md80av8r/AudioBox/report.txt

Plotted to '/Users/jeffreykadans/Developer/MicBreakoutBoxrev_C/REV.C.MAIN.BOARD.COMPLETE/md88_breakout_main_revC-F_Cu.gbr'.
Plotted to '/Users/jeffreykadans/Developer/MicBreakoutBoxrev_C/REV.C.MAIN.BOARD.COMPLETE/md88_breakout_main_revC-In1_Cu.gbr'.
Plotted to '/Users/jeffreykadans/Developer/MicBreakoutBoxrev_C/REV.C.MAIN.BOARD.COMPLETE/md88_breakout_main_revC-In2_Cu.gbr'.
Plotted to '/Users/jeffreykadans/Developer/MicBreakoutBoxrev_C/REV.C.MAIN.BOARD.COMPLETE/md88_breakout_main_revC-B_Cu.gbr'.
Plotted to '/Users/jeffreykadans/Developer/MicBreakoutBoxrev_C/REV.C.MAIN.BOARD.COMPLETE/md88_breakout_main_revC-F_Adhesive.gbr'.
Plotted to '/Users/jeffreykadans/Developer/MicBreakoutBoxrev_C/REV.C.MAIN.BOARD.COMPLETE/md88_breakout_main_revC-B_Adhesive.gbr'.
Plotted to '/Users/jeffreykadans/Developer/MicBreakoutBoxrev_C/REV.C.MAIN.BOARD.COMPLETE/md88_breakout_main_revC-F_Paste.gbr'.
Plotted to '/Users/jeffreykadans/Developer/MicBreakoutBoxrev_C/REV.C.MAIN.BOARD.COMPLETE/md88_breakout_main_revC-B_Paste.gbr'.
Plotted to '/Users/jeffreykadans/Developer/MicBreakoutBoxrev_C/REV.C.MAIN.BOARD.COMPLETE/md88_breakout_main_revC-F_Silkscreen.gbr'.
Plotted to '/Users/jeffreykadans/Developer/MicBreakoutBoxrev_C/REV.C.MAIN.BOARD.COMPLETE/md88_breakout_main_revC-B_Silkscreen.gbr'.
Plotted to '/Users/jeffreykadans/Developer/MicBreakoutBoxrev_C/REV.C.MAIN.BOARD.COMPLETE/md88_breakout_main_revC-F_Mask.gbr'.
Plotted to '/Users/jeffreykadans/Developer/MicBreakoutBoxrev_C/REV.C.MAIN.BOARD.COMPLETE/md88_breakout_main_revC-B_Mask.gbr'.
Plotted to '/Users/jeffreykadans/Developer/MicBreakoutBoxrev_C/REV.C.MAIN.BOARD.COMPLETE/md88_breakout_main_revC-Edge_Cuts.gbr'.
Created Gerber job file '/Users/jeffreykadans/Developer/MicBreakoutBoxrev_C/REV.C.MAIN.BOARD.COMPLETE/md88_breakout_main_revC-job.gbrjob'.
Info: Done.
