md80av8r/AudioBox/audio_companion/fab_v7/board_bottom.png

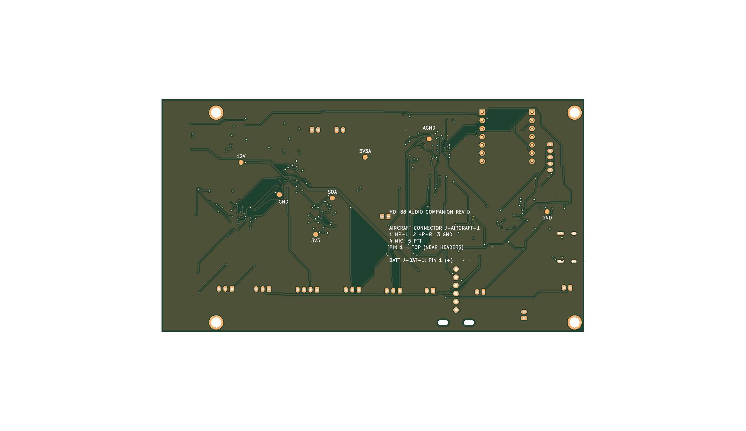
audio_companion/fab_v7/board_bottom.png
