md80av8r/AudioBox/audio_companion/fab_v7/board_top.png

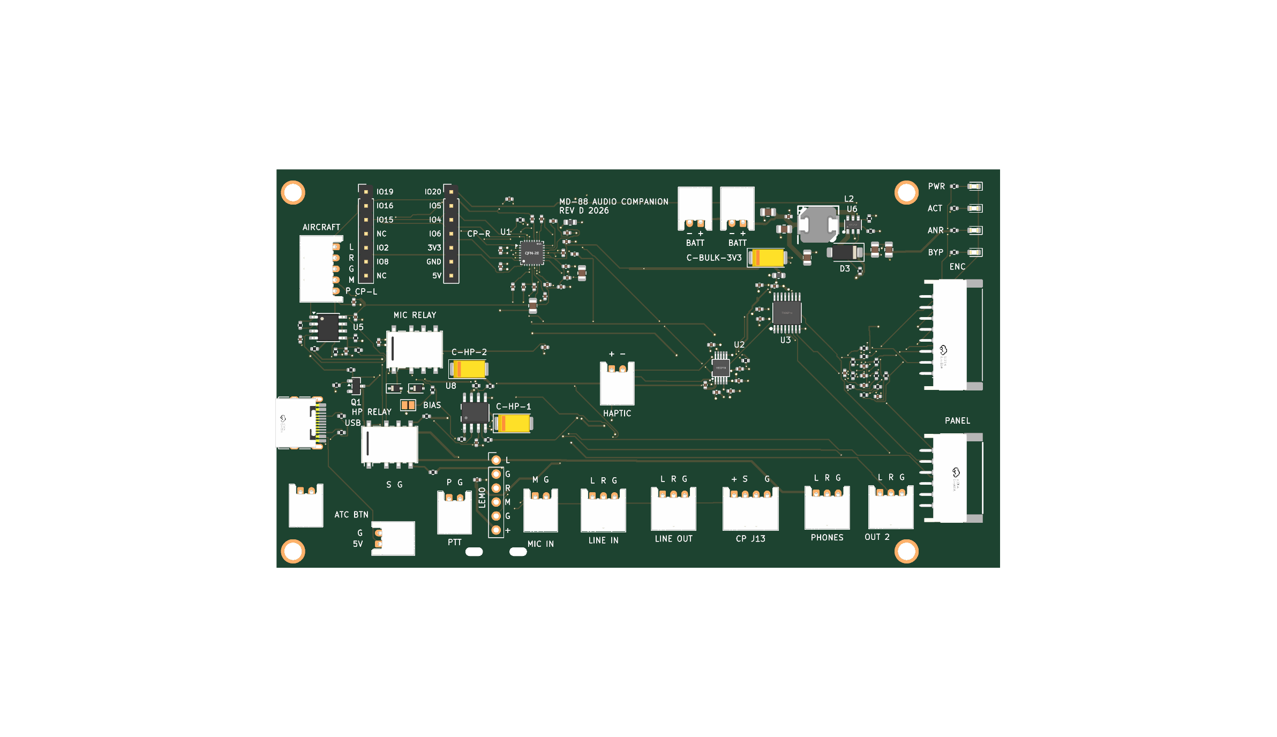
audio_companion/fab_v7/board_top.png
