md80av8r/AudioBox/REV.C.MAIN.BOARD.COMPLETE/BOM_JLCPCB.csv

Comment | Designator | Footprint | LCSC Part #
18650_CELL | BT1 | CONN-SMD_B2B-PH-SM4-TB-LF-SN | C160352
100nF | C1,C2,C3,C14,C16,C20,C21,C23,C25,C26,C29,C_HP_VCC_DECAP1 | C_0805_2012Metric | C49678
10uF | C6,C9,C12,C13,C18,C_HP_VCC_BULK1 | C_0805_2012Metric | C15850
1uF | C8,C17,C_BYPASS1 | C_0805_2012Metric | C28323
22uF | C10,C11,C15,C19,C24 | C_0805_2012Metric | C45783
10uF | C22,C_AC_COUPLE1,C_AF1 | C_1210_3225Metric
MIC_PIGTAIL_0206 | CABLE1 | CONN-SMD_B2B-PH-SM4-TB-LF-SN | C160352
AUDIO_PIGTAIL_QUARTER_INCH | CABLE2 | CONN-SMD_B3B-PH-SM4-TB-LF-SN | C160353
B2B-PH-SM4-TB | CN2,CN3 | CONN-SMD_B2B-PH-SM4-TB-LF-SN | C160352
100nF | C_AF_BIAS1 | C_1210_3225Metric
1nF | C_HP_FILTER1 | C_0805_2012Metric | C46653
PM101M025E077PTR | C_OUT_L1,C_OUT_R1 | CAP-SMD_BD6.3-L6.6-W6.6-LS7.2-FD | C2858382
SS24 | D1,D3 | SMA_L4.3-W2.6-LS5.2-RD | C50645
LED_CHRG_RED | D4 | LED_0805_2012Metric
LED_CHRG_GREEN | D5 | LED_0805_2012Metric
FH28K-20S-0.5SH | FPC1 | CONN-SMD_FH28K-20S-0.5SH | C3168665
USB_C_POWER | J1 | USB_C_Receptacle_HRO_TYPE-C-31-M-12 | C165948
AUDIO_OUT_QUARTER_INCH | J2 | CONN-SMD_B3B-PH-SM4-TB-LF-SN | C160353
MIC_OUT_0206 | J3 | CONN-SMD_B3B-PH-SM4-TB-LF-SN | C160353
LEMO_6PIN_PROFLIGHT | J4 | CONN-SMD_6P-P2.00_B6B-PH-SM4-TB-LF-SN | C471518
AUX_IN_3.5MM | J5 | CONN-SMD_B3B-PH-SM4-TB-LF-SN | C160353
4.7uH | L1,L2 | IND-SMD_L4.0-W4.0_LQH44PN2R2MP0L | C135263
SMNR4020-10UH | L3 | IND-SMD_L4.0-W4.0_LQH44PN2R2MP0L | C135263
FS8205A_C2830320 | Q1 | SOT-23-6_L2.9-W1.6-P0.95-LS2.8-BR | C2830320
MMBT3904-C20526 | Q2,Q3,Q5 | SOT-23-3_L2.9-W1.3-P1.90-LS2.4-BR | C20526
AO3401A | Q4 | SOT-23_L2.9-W1.3-P1.90-LS2.4-BR | C15127
4.7k | R1,R29 | R_0805_2012Metric | C17673
10k | R2,R15,R21,R27,R28,R30,R31,R32,R33,R40,R41,R_AF1,R_AF2,R_BASE_PD1,R_BTN_BASE1,R_BTN_BASE2,R_BTN_BASE3,R_HOLD_BASE1,R_PWR_PU1 | R_0805_2012Metric | C17414
470 | R6 | R_0805_2012Metric | C17710
100k | R8,R9,R18,R19,R34,R35,R36,R_AF_BIAS1,R_AF_BIAS2,R_SHUTDOWN1 | R_0805_2012Metric | C17407
180k | R14 | R_0805_2012Metric | C22827
200k | R16 | R_0805_2012Metric | C17539
27k | R17 | R_0805_2012Metric | C17593
1k | R22,R23 | R_0805_2012Metric | C17513
100 | R24 | R_0805_2012Metric | C17408
5.1k | R25,R26 | R_0805_2012Metric | C27834
ESP32-WROVER-E-N8R8 | U1 | WIFI-SMD_ESP32-WROVER-IE8MB | C2973667
DS3231SN#_C722469 | U2 | SOIC-16_L10.3-W7.5-P1.27-LS10.3-BL | C722469
BME280 | U3 | LGA-8_BME280_BL | C92489
MT3608 | U9,U10 | SOT-23-6
TP4056 | U11 | ESOP-8_L4.9-W3.9-P1.27-LS6.0-BL-EP | C16581
DW01A_C351410 | U12 | SOT-23-6_L2.9-W1.6-P0.95-LS2.8-BL | C351410
AMS1117-3.3 | U13 | SOT-223-3_L6.5-W3.4-P2.30-LS7.0-BR | C6186
CH340C_C7464026 | U14 | SOP-16_L10.0-W3.9-P1.27-LS6.0-BL | C7464026
MAX98357AETE+T | U15 | TQFN-16_L3.0-W3.0-P0.50-BL-EP1.5 | C910544
TPA6111A2DR | U16 | SOIC-8_L5.0-W4.0-P1.27-LS6.0-BL | C497472
