md80av8r/AudioBox/audio_companion/fab_v7/BOM_full.csv

Value | Designators | Qty | Package | Manufacturer part | LCSC # | Assembly | Notes
S5B-PH-K-S | J-AIRCRAFT-1 | 1 | THT | S5B-PH-K-S(LF)(SN) | C157923 | hand solder | JST PH 5-pin side entry
S4B-PH-K-S | J-BTN-IN-1 | 1 | THT | S4B-PH-K-S(LF)(SN) | C157926 | hand solder | JST PH 4-pin side entry
S3B-PH-K-S | J-35-1,J-35-2,J-35-3,J-635-IN-1 | 4 | THT | S3B-PH-K-S(LF)(SN) | C157929 | hand solder | JST PH 3-pin side entry
S2B-PH-K-S | J-BAT-1,J-BAT-2,J-BTN-1,J-HAPTIC-1,J-MIC-IN-1,J-USB5V-1,PTT_PASS/GND-1 | 7 | THT | S2B-PH-K-S(LF)(SN) | C173752 | hand solder | JST PH 2-pin side entry
Conn_01x07_Socket | HDR-CP-L-1,HDR-CP-R-1 | 2 | THT | 1x7 male header, 19mm LONG pins | NOT_ON_LCSC | hand solder | stack-on to CrowPanel - source separately, pin length must bridge the 10mm gap
LEMO-6P | J-LEMO-1 | 1 | holes | (6 plated holes) | - | no part | LEMO pigtail wires soldered direct + zip-tie slots
SolderJumper | JP-MIC-BIAS-1 | 1 | pads | (PCB pads only) | - | no part | MIC BIAS jumper - bridge with solder to enable electret bias
TP | TP1,TP2,TP3,TP4,TP5,TP6,TP7 | 7 | pads | (PCB pads only) | - | no part | bottom test pads
1k | R9,R-GATE-1 | 2 | 0402 | 0402WGF1001TCE | C11702 | JLCPCB assembles | 1k
LED Green | D4 | 1 | 0603 | KT-0603G | C12624 | JLCPCB assembles | PWR - emerald green
10nF | C-ENC-IA,C-ENC-IB,C-ENC-OA,C-ENC-OB,C-ENC-PUSH | 5 | 0402 | CL05B103KB5NNNC | C15195 | JLCPCB assembles | 10nF 50V X7R - encoder debounce
100nF | C3,C6,C19,C22,C28,C30,C35,C37,C44,C47,C-DRV-VDD-1 | 11 | 0402 | CL05B104KO5NNNC | C1525 | JLCPCB assembles | 100nF 16V X7R
10uF | C7,C8,C20,C21,C25,C27,C33,C34,C36,C38,C41,C42,C43,C45,C48,C49,C50,C-DRV-VDD-2 | 18 | 0402 | CL05A106MQ5NUNC | C15525 | JLCPCB assembles | 10uF 6.3V X5R (3V3 rails only)
10uF | C1,C2 | 2 | 0805 | CL21A106KAYNNNE | C15850 | JLCPCB assembles | 10uF 25V X5R
TYPE-C-31-M-12 | J-USB-1 | 1 | USB-C 16P SMD | TYPE-C-31-M-12 | C165948 | JLCPCB assembles | power-in jack (left edge)
0 | R1 | 1 | 0402 | 0402WGF0000TCE | C17168 | JLCPCB assembles | 0R AGND/GND tie
FerriteBead | FB1,FB3 | 2 | 0603 | BLM18AG601SN1D | C19330 | JLCPCB assembles | 600R@100MHz 500mA
220UF | C-BULK-3V3 | 1 | 6032-28 | T491C227M006AT | C1952817 | JLCPCB assembles | 220uF 6.3V tantalum - + toward pad 1 marking
220uF 6.3V | C-HP-1,C-HP-2 | 2 | 6032-28 | T491C227M006AT | C1952817 | JLCPCB assembles | 220uF 6.3V tantalum - headphone output coupling, + toward TPA
AO3400A | Q1 | 1 | SOT-23 | AO3400A | C20917 | JLCPCB assembles | relay driver, logic-level 30V 5.7A, Basic
1N4148WS | D1,D2 | 2 | SOD-323 | 1N4148WS | C2128 | JLCPCB assembles | relay flyback
G6K-2F-Y DC3 | HEADPHONE_BYPASS-1,MIC_BYPASS-1 | 2 | SMD 10x6.5 | G6K-2F-Y-TR DC3 | C2153097 | JLCPCB assembles | Omron DPDT 3V coil SMT (alt C93168, not recommended for new designs)
LED Red | D7 | 1 | 0603 | KT-0603R | C2286 | JLCPCB assembles | BYPASS - red
LED Yellow | D5 | 1 | 0603 | KT-0603Y | C2287 | JLCPCB assembles | ACTIVE - yellow
LED White | D6 | 1 | 0603 | KT-0603W | C2290 | JLCPCB assembles | ANR 12V - white
SS14 | D3 | 1 | SMA | SS14 | C2480 | JLCPCB assembles | Schottky 40V 1A - boost rectifier
100R | R12 | 1 | 0402 | 0402WGF1000TCE | C25076 | JLCPCB assembles | 100R
10R | R-HP-1,R-HP-2 | 2 | 0402 | 0402WGF100JTCE | C25077 | JLCPCB assembles | 10R
330R | R13,R15 | 2 | 0402 | 0402WGF3300TCE | C25104 | JLCPCB assembles | 330R
100k | R8,R-MICBIAS-1 | 2 | 0402 | 0402WGF1003TCE | C25741 | JLCPCB assembles | 100k
10k | R11,R-BIAS1,R-BIAS2,R-BYP-SENSE-1,R-ENC-PU-IA,R-ENC-PU-IB,R-ENC-PU-OA,R-ENC-PU-OB,R-ENC-PU-PUSH,R-ENC-S-IA,R-ENC-S-IB,R-ENC-S-OA,R-ENC-S-OB,R-ENC-S-PUSH,R-PULL-1,R-TPA-FB-1,R-TPA-FB-2,R-TPA-IN-1,R-TPA-IN-2 | 19 | 0402 | 0402WGF1002TCE | C25744 | JLCPCB assembles | 10k
200k | R-FB-TOP-2 | 1 | 0402 | 0402WGF2003TCE | C25764 | JLCPCB assembles | 200k
22k | R10 | 1 | 0402 | 0402WGF2202TCE | C25768 | JLCPCB assembles | 22k
2.2k | R14,R-ELEC-1 | 2 | 0402 | 0402WGF2201TCE | C25879 | JLCPCB assembles | 2.2k
5.1k | R-CC-1,R-CC-2 | 2 | 0402 | 0402WGF5101TCE | C25905 | JLCPCB assembles | 5.1k CC pull-down for USB-C power-in
S8B-PH-SM4-TB | J-ENC-1 | 1 | JST PH 8P SMD side | S8B-PH-SM4-TB(LF)(SN) | C265121 | JLCPCB assembles | encoder cable connector
S6B-PH-SM4-TB | J-PANEL-1 | 1 | JST PH 6P SMD side | S6B-PH-SM4-TB(LF)(SN) | C265405 | JLCPCB assembles | panel switches cable connector
PCA9534APWR | U3 | 1 | TSSOP-16 | PCA9534APWR | C2871127 | JLCPCB assembles | I2C IO expander
ES8388 | U1 | 1 | QFN-28-EP(4x4) | ES8388 | C365736 | JLCPCB assembles | audio codec
22uF 10V | C29,C31,C32 | 3 | 0805 | CL21A226MAQNNNE | C45783 | JLCPCB assembles | 22uF 25V X5R (covers 10V use)
22uF 25V | C46,C51 | 2 | 0805 | CL21A226MAQNNNE | C45783 | JLCPCB assembles | 22uF 25V X5R - boost output, must be >=25V
TPA6111A2DR | U8 | 1 | SOIC-8 | TPA6111A2DR | C497472 | JLCPCB assembles | headphone amp
DRV2605LDGSR | U2 | 1 | VSSOP-10 | DRV2605LDGSR | C527464 | JLCPCB assembles | haptic driver
1uF | C9,C23,C24,C26,C39,C40,C-DRV-REG-1 | 7 | 0402 | CL05A105KA5NQNC | C52923 | JLCPCB assembles | 1uF 25V X5R
1uF 25V | C-MIC-AIR-1 | 1 | 0402 | CL05A105KA5NQNC | C52923 | JLCPCB assembles | 1uF 25V X5R - mic DC block, keep >=16V
MCP6022 | U5 | 1 | SOIC-8 | MCP6022T-I/SN | C57639 | JLCPCB assembles | dual op amp
SPM6530T-4R7M | L2 | 1 | 7.1x6.5 | SPM6530T-4R7M | C76857 | JLCPCB assembles | TDK 4.7uH 5.6A
MT3608 | U6 | 1 | SOT-23-6 | MT3608 | C84817 | JLCPCB assembles | 12V boost
