md80av8r/AudioBox/md88_breakout/gerbers/md88_breakout_BOM_JLCPCB.csv

Comment | Designator | Footprint | LCSC Part #
100nF | C3 | 0805 | C49678
1uF | C8 | 0805 | C28323
4.7k | R1 | 0805 | C17730
10k | R2,R3,R4,R5,R10,R11 | 0805 | C17414
470 | R6 | 0805 | C17745
100k | R8,R9,R18,R19 | 0805 | C17407
5.1k | R12,R13 | 0805 | C23186
