md80av8r/AudioBox/REV.C.PANEL.BOARD.COMPLETE/BOM_JLCPCB.csv

Comment | Designator | Footprint | LCSC Part #
100nF | C1,C3 | C_0805_2012Metric | C49678
KH-FG0.5-H2.0-14PIN | CN2 | FPC-SMD_KH-FG0.5-H2.0-14PIN | C2797208
FH28K-20S-0.5SH | FPC2 | CONN-SMD_FH28K-20S-0.5SH | C3168665
10k | R2,R4,R5 | R_0805_2012Metric | C17414
4.7k | R6,R7 | R_0805_2012Metric | C17673
EC11E15244G1 | SW1 | SW-TH_EC11E15244G1 | C370970
EVPAA202K | SW3 | KEY-SMD_4P-L3.5-W2.9-P1.48-LS4.3-TL | C79147
