md80av8r/AudioBox/audio_companion/3d/CONN-SMD_PH2.00-WS-6P.step

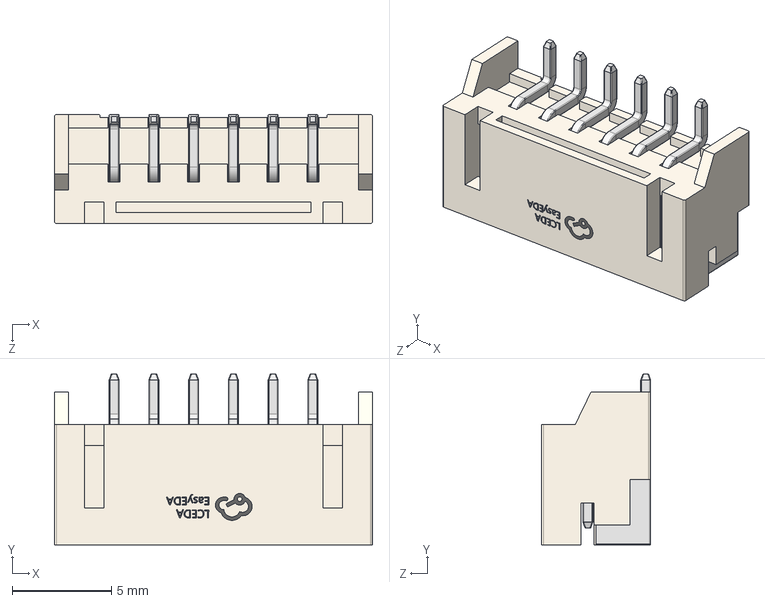
[picture p3: CAD file, 2026-11-12]
audio_companion/3d/CONN-SMD_PH2.00-WS-6P.step
16.0 x 8.60 x 5.50 mm
