md80av8r/AudioBox/audio_companion/3d/CONN-SMD_PH2.00-WS-8P.step

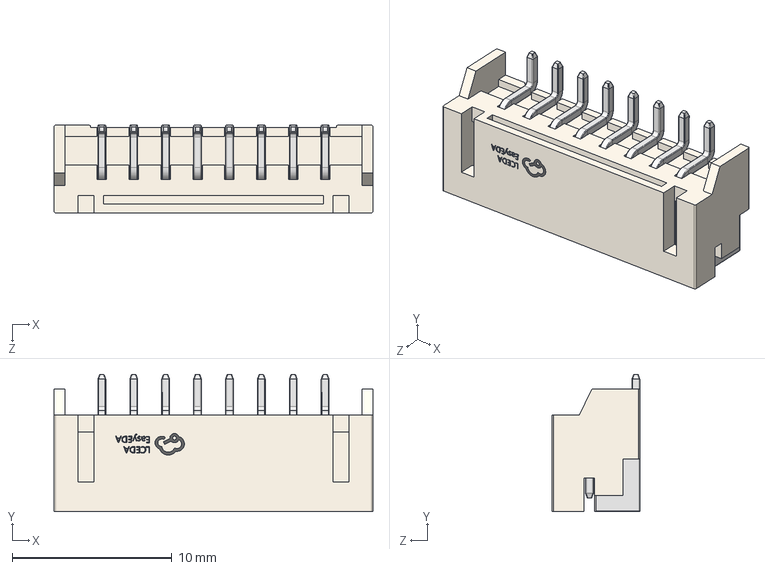
[picture p4: CAD file, 2026-11-12]
audio_companion/3d/CONN-SMD_PH2.00-WS-8P.step
20.0 x 8.60 x 5.50 mm
