md80av8r/AudioBox/md88_breakout/kicad.pdf

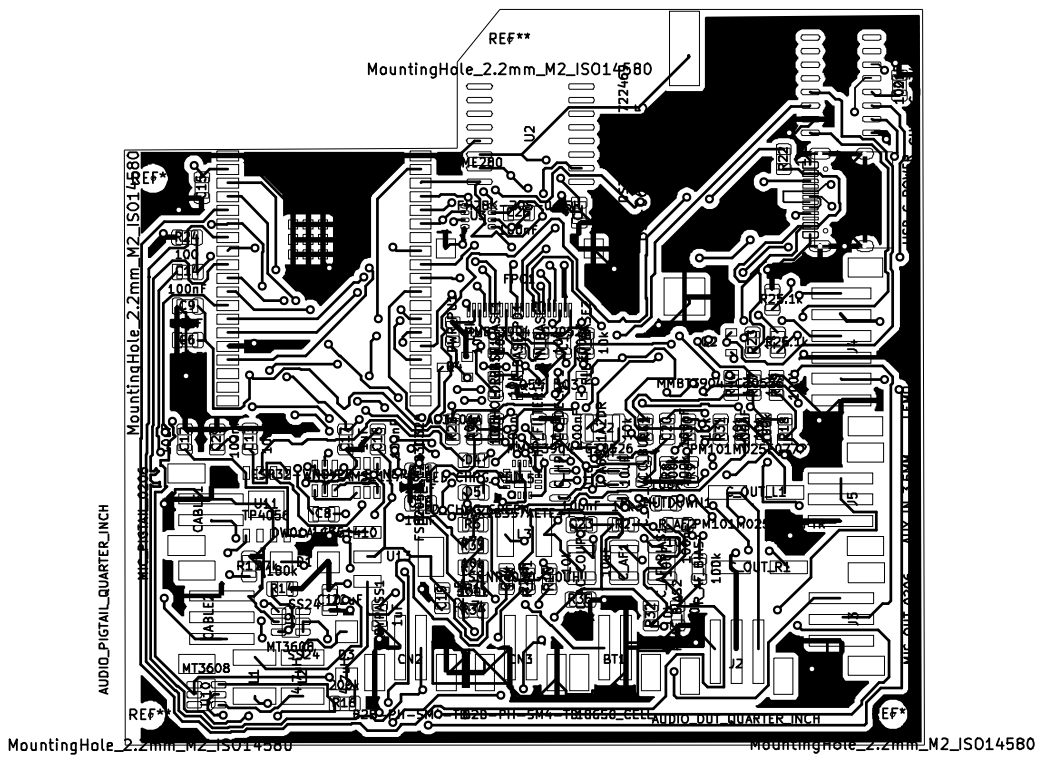
[picture p5: page 1]
