md80av8r/AudioBox/(list of files, drawings)

Other design files:
md88_breakout/_archive_revB/md88_breakout.dsn
