md80av8r/AudioBox/audio_companion/audio_companion.kicad_pcb

## KiCad design audio_companion/audio_companion.kicad_pcb (2026-11-12)

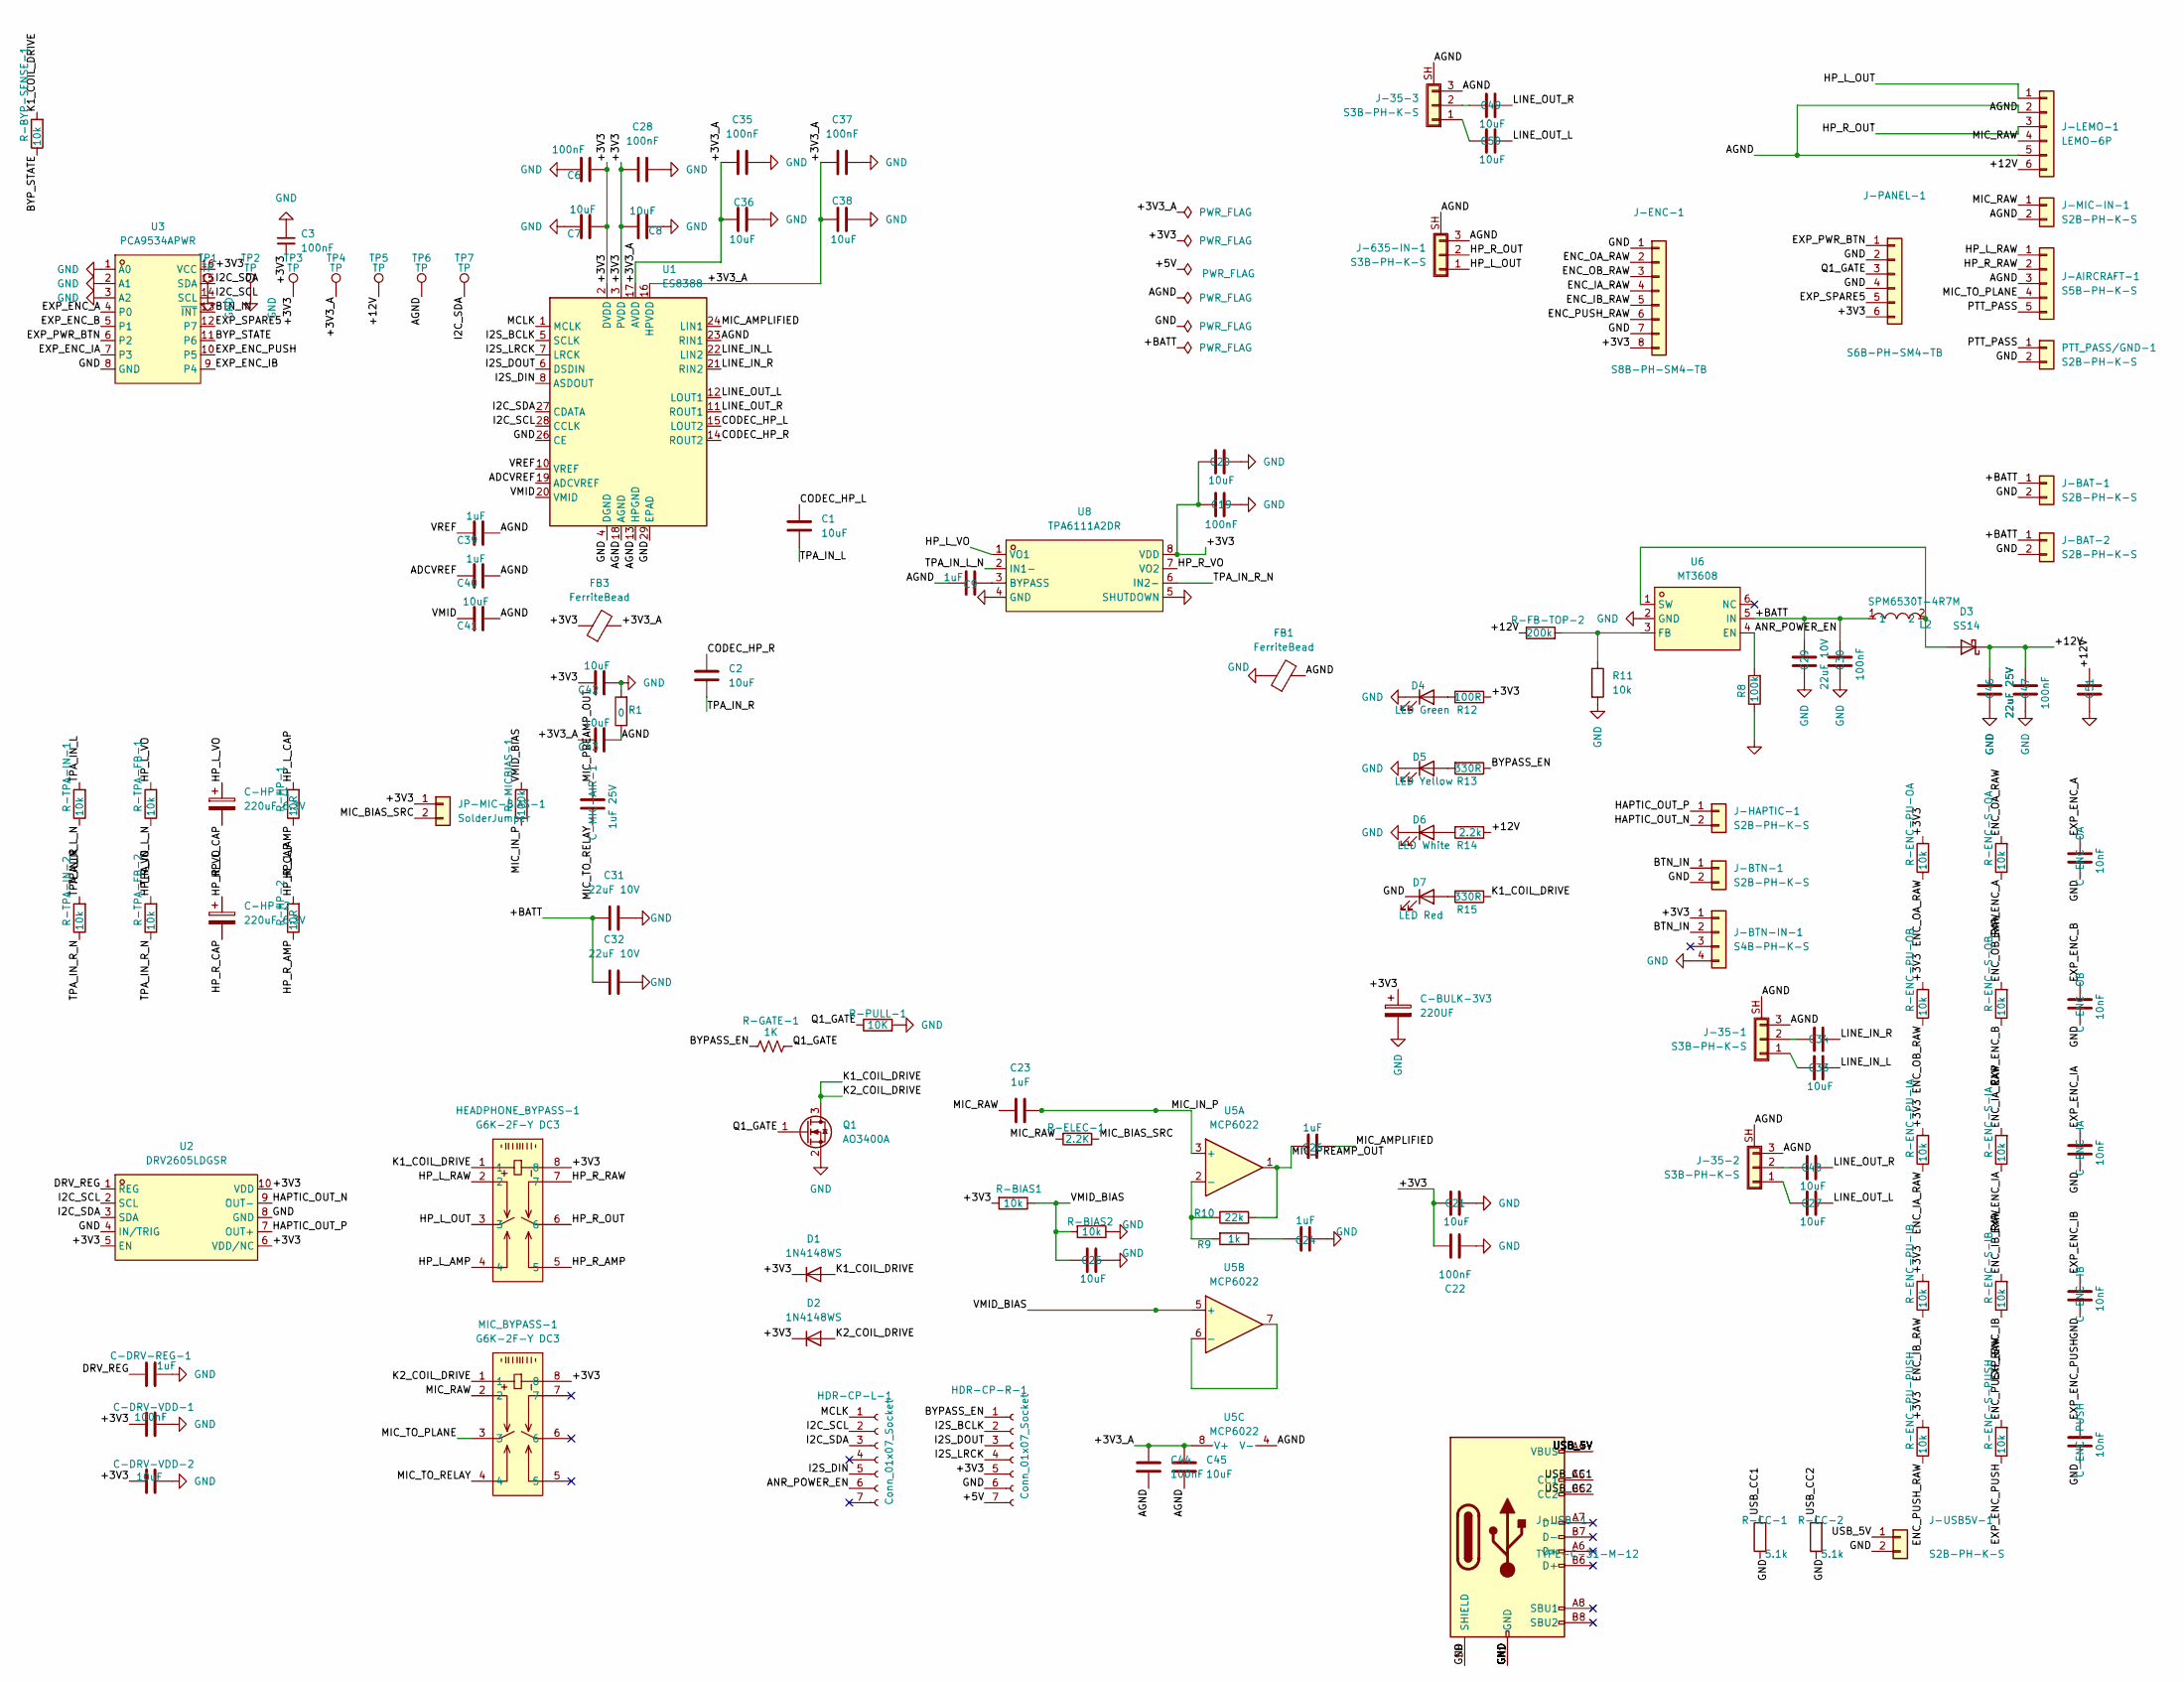
[picture p6: schematic audio_companion.kicad_sch, MD-88 Audio Companion v1.0]

Parts:
C1, C2: 10uF; C_0805_2012Metric
C3, C6, C19, C22, C28, C30, C35, C37, C44, C47: 100nF; C_0402_1005Metric
C7, C8, C20, C21, C25, C27, C33, C34, C36, C38, C41, C42, C43, C45, C48, C49, C50: 10uF; C_0402_1005Metric
C9, C23, C24, C26, C39, C40: 1uF; C_0402_1005Metric
C29, C31, C32: 22uF 10V; C_0805_2012Metric
C46, C51: 22uF 25V; C_0805_2012Metric
C-BULK-3V3: 220UF; CP_EIA-6032-28_Kemet-C
C-DRV-REG-1: 1uF; C_0402_1005Metric
C-DRV-VDD-1: 100nF; C_0402_1005Metric
C-DRV-VDD-2: 10uF; C_0402_1005Metric
C-ENC-IA: 10nF; C_0402_1005Metric
C-ENC-IB: 10nF; C_0402_1005Metric
C-ENC-OA: 10nF; C_0402_1005Metric
C-ENC-OB: 10nF; C_0402_1005Metric
C-ENC-PUSH: 10nF; C_0402_1005Metric
C-HP-1, C-HP-2: 220uF 6.3V; CP_EIA-6032-28_Kemet-C
C-MIC-AIR-1: 1uF 25V; C_0402_1005Metric
D1, D2: 1N4148WS; D_SOD-323
D3: SS14; D_SMA
D4: LED Green; LED_0603_1608Metric
D5: LED Yellow; LED_0603_1608Metric
D6: LED White; LED_0603_1608Metric
D7: LED Red; LED_0603_1608Metric
FB1, FB3: FerriteBead; L_0603_1608Metric
HDR-CP-L-1: Conn_01x07_Socket; PinHeader_1x07_P2.54mm_Vertical
HDR-CP-R-1: Conn_01x07_Socket; PinHeader_1x07_P2.54mm_Vertical
HEADPHONE_BYPASS-1: G6K-2F-Y DC3; Relay_DPDT_Omron_G6K-2F-Y; MPN G6K-2F-Y DC3; LCSC Part C93168
J-35-1, J-35-2, J-35-3, J-635-IN-1: S3B-PH-K-S; JST_PH_S3B-PH-K_1x03_P2.00mm_Horizontal
J-AIRCRAFT-1: S5B-PH-K-S; JST_PH_S5B-PH-K_1x05_P2.00mm_Horizontal
J-BAT-1, J-BAT-2: S2B-PH-K-S; JST_PH_S2B-PH-K_1x02_P2.00mm_Horizontal
J-BTN-1: S2B-PH-K-S; JST_PH_S2B-PH-K_1x02_P2.00mm_Horizontal
J-BTN-IN-1: S4B-PH-K-S; JST_PH_S4B-PH-K_1x04_P2.00mm_Horizontal
J-ENC-1: S8B-PH-SM4-TB; JST_PH_S8B-PH-SM4-TB_1x08-1MP_P2.00mm_Horizontal; MPN S8B-PH-SM4-TB(LF)(SN)
J-HAPTIC-1: S2B-PH-K-S; JST_PH_S2B-PH-K_1x02_P2.00mm_Horizontal
J-LEMO-1: LEMO-6P; PinHeader_1x06_P2.54mm_Vertical
J-MIC-IN-1: S2B-PH-K-S; JST_PH_S2B-PH-K_1x02_P2.00mm_Horizontal
J-PANEL-1: S6B-PH-SM4-TB; JST_PH_S6B-PH-SM4-TB_1x06-1MP_P2.00mm_Horizontal; MPN S6B-PH-SM4-TB(LF)(SN)
J-USB5V-1: S2B-PH-K-S; JST_PH_S2B-PH-K_1x02_P2.00mm_Horizontal; MPN S2B-PH-K-S
J-USB-1: TYPE-C-31-M-12; USB_C_Receptacle_HRO_TYPE-C-31-M-12; MPN TYPE-C-31-M-12; LCSC C165948
JP-MIC-BIAS-1: SolderJumper; SolderJumper-2_P1.3mm_Open_Pad1.0x1.5mm
L2: SPM6530T-4R7M; IND-SMD_L7.1-W6.5; MPN SPM6530T-4R7M; LCSC Part C76857
MIC_BYPASS-1: G6K-2F-Y DC3; Relay_DPDT_Omron_G6K-2F-Y; MPN G6K-2F-Y DC3; LCSC Part C93168
PTT_PASS/GND-1: S2B-PH-K-S; JST_PH_S2B-PH-K_1x02_P2.00mm_Horizontal
Q1: AO3400A; SOT-23
R1: 0; R_0402_1005Metric
R8: 100k; R_0402_1005Metric
R9: 1k; R_0402_1005Metric
R10: 22k; R_0402_1005Metric
R11: 10k; R_0402_1005Metric
R12: 100R; R_0402_1005Metric
R13, R15: 330R; R_0402_1005Metric
R14: 2.2k; R_0402_1005Metric
R-BIAS1, R-BIAS2: 10k; R_0402_1005Metric
R-BYP-SENSE-1: 10k; R_0402_1005Metric
R-CC-1, R-CC-2: 5.1k; R_0402_1005Metric; LCSC C25905
R-ELEC-1: 2.2K; R_0402_1005Metric
R-ENC-PU-IA: 10k; R_0402_1005Metric
R-ENC-PU-IB: 10k; R_0402_1005Metric
R-ENC-PU-OA: 10k; R_0402_1005Metric
R-ENC-PU-OB: 10k; R_0402_1005Metric
R-ENC-PU-PUSH: 10k; R_0402_1005Metric
R-ENC-S-IA: 10k; R_0402_1005Metric
R-ENC-S-IB: 10k; R_0402_1005Metric
R-ENC-S-OA: 10k; R_0402_1005Metric
R-ENC-S-OB: 10k; R_0402_1005Metric
R-ENC-S-PUSH: 10k; R_0402_1005Metric
R-FB-TOP-2: 200k; R_0402_1005Metric
R-GATE-1: 1K; R_0402_1005Metric
R-HP-1, R-HP-2: 10R; R_0402_1005Metric
R-MICBIAS-1: 100k; R_0402_1005Metric
R-PULL-1: 10K; R_0402_1005Metric
R-TPA-FB-1, R-TPA-FB-2: 10k; R_0402_1005Metric
R-TPA-IN-1, R-TPA-IN-2: 10k; R_0402_1005Metric
TP1, TP2, TP3, TP4, TP5, TP6, TP7: TP; TestPoint_Pad_D1.5mm
U1: ES8388; QFN-28-1EP_4x4mm_P0.45mm_EP2.6x2.6mm
U2: DRV2605LDGSR; VSSOP-10_L3.0-W3.0-P0.50-LS4.9-BL; MPN DRV2605LDGSR; LCSC Part C527464
U3: PCA9534APWR; TSSOP-16_L5.0-W4.4-P0.65-LS6.4-BL; MPN PCA9534APWR; LCSC Part C2871127
U5: MCP6022; SOIC-8_3.9x4.9mm_P1.27mm
U6: MT3608; SOT-23-6_L2.9-W1.6-P0.95-LS2.8-BL; MPN MT3608; LCSC Part C84817
U8: TPA6111A2DR; SOIC-8_L5.0-W4.0-P1.27-LS6.0-BL; MPN TPA6111A2DR; LCSC Part C497472

Connections:
/+3V3: C3.2, C6.1, C7.1, C8.1, C19.2, C20.1, C21.1, C22.2, C28.1, C42.2, C-BULK-3V3.1, C-DRV-VDD-1.1, C-DRV-VDD-2.1, D1.1 (K), D2.1 (K), FB3.1, HDR-CP-R-1.5, HEADPHONE_BYPASS-1.8, J-BTN-IN-1.1, J-ENC-1.8, J-PANEL-1.6, JP-MIC-BIAS-1.1, MIC_BYPASS-1.8, R12.1, R-BIAS1.2, R-ENC-PU-IA.2, R-ENC-PU-IB.2, R-ENC-PU-OA.2, R-ENC-PU-OB.2, R-ENC-PU-PUSH.2, TP3.1, U1.2 (DVDD), U1.3 (PVDD), U2.5 (EN), U2.6 (VDD/NC), U2.10 (VDD), U3.16 (VCC), U8.8 (VDD)
/+3V3_A: C35.1, C36.1, C37.1, C38.1, C43.2, C44.1, C45.1, FB3.2, TP4.1, U1.16 (HPVDD), U1.17 (AVDD), U5.8 (V+)
/+5V: HDR-CP-R-1.7
/+12V: C46.1, C47.1, C51.1, D3.1 (K), J-LEMO-1.6, R14.1, R-FB-TOP-2.1, TP5.1
/+BATT: C29.1, C30.1, C31.2, C32.2, J-BAT-1.1, J-BAT-2.1, L2.1, U6.5 (IN)
/ADCVREF: C40.2, U1.19 (ADCVREF)
/AGND: C9.1, C39.1, C40.1, C41.1, C43.1, C44.2, C45.2, FB1.2, J-35-1.3, J-35-1.SH (Shield), J-35-2.3, J-35-2.SH (Shield), J-35-3.3, J-35-3.SH (Shield), J-635-IN-1.3, J-635-IN-1.SH (Shield), J-AIRCRAFT-1.3, J-LEMO-1.2, J-LEMO-1.5, J-MIC-IN-1.2, R1.1, TP6.1, U1.13 (HPGND), U1.18 (AGND), U1.23 (RIN1), U5.4 (V-)
/ANR_POWER_EN: HDR-CP-L-1.6, R8.2, U6.4 (EN)
/BTN_IN: J-BTN-1.1, J-BTN-IN-1.2, U3.13 (~INT)
/BYPASS_EN: HDR-CP-R-1.1, R13.1, R-GATE-1.1
/BYP_STATE: R-BYP-SENSE-1.1, U3.11 (P6)
/CODEC_HP_L: C1.2, U1.15 (LOUT2)
/CODEC_HP_R: C2.2, U1.14 (ROUT2)
/DRV_REG: C-DRV-REG-1.1, U2.1 (REG)
/ENC_IA_RAW: J-ENC-1.4, R-ENC-PU-IA.1, R-ENC-S-IA.2
/ENC_IB_RAW: J-ENC-1.5, R-ENC-PU-IB.1, R-ENC-S-IB.2
/ENC_OA_RAW: J-ENC-1.2, R-ENC-PU-OA.1, R-ENC-S-OA.2
/ENC_OB_RAW: J-ENC-1.3, R-ENC-PU-OB.1, R-ENC-S-OB.2
/ENC_PUSH_RAW: J-ENC-1.6, R-ENC-PU-PUSH.1, R-ENC-S-PUSH.2
/EXP_ENC_A: C-ENC-OA.1, R-ENC-S-OA.1, U3.4 (P0)
/EXP_ENC_B: C-ENC-OB.1, R-ENC-S-OB.1, U3.5 (P1)
/EXP_ENC_IA: C-ENC-IA.1, R-ENC-S-IA.1, U3.7 (P3)
/EXP_ENC_IB: C-ENC-IB.1, R-ENC-S-IB.1, U3.9 (P4)
/EXP_ENC_PUSH: C-ENC-PUSH.1, R-ENC-S-PUSH.1, U3.10 (P5)
/EXP_PWR_BTN: J-PANEL-1.1, U3.6 (P2)
/EXP_SPARE5: J-PANEL-1.5, U3.12 (P7)
/HAPTIC_OUT_N: J-HAPTIC-1.2, U2.9 (OUT-)
/HAPTIC_OUT_P: J-HAPTIC-1.1, U2.7 (OUT+)
/HP_L_AMP: HEADPHONE_BYPASS-1.4, R-HP-1.1
/HP_L_CAP: C-HP-1.2, R-HP-1.2
/HP_L_OUT: HEADPHONE_BYPASS-1.3, J-635-IN-1.1, J-LEMO-1.1
/HP_L_RAW: HEADPHONE_BYPASS-1.2, J-AIRCRAFT-1.1
/HP_L_VO: C-HP-1.1, R-TPA-FB-1.2, U8.1 (VO1)
/HP_R_AMP: HEADPHONE_BYPASS-1.5, R-HP-2.1
/HP_R_CAP: C-HP-2.2, R-HP-2.2
/HP_R_OUT: HEADPHONE_BYPASS-1.6, J-635-IN-1.2, J-LEMO-1.3
/HP_R_RAW: HEADPHONE_BYPASS-1.7, J-AIRCRAFT-1.2
/HP_R_VO: C-HP-2.1, R-TPA-FB-2.2, U8.7 (VO2)
/I2C_SCL: HDR-CP-L-1.2, U1.28 (CCLK), U2.2 (SCL), U3.14 (SCL)
/I2C_SDA: HDR-CP-L-1.3, TP7.1, U1.27 (CDATA), U2.3 (SDA), U3.15 (SDA)
/I2S_BCLK: HDR-CP-R-1.2, U1.5 (SCLK)
/I2S_DIN: HDR-CP-L-1.5, U1.8 (ASDOUT)
/I2S_DOUT: HDR-CP-R-1.3, U1.6 (DSDIN)
/I2S_LRCK: HDR-CP-R-1.4, U1.7 (LRCK)
/K1_COIL_DRIVE: D1.2 (A), D2.2 (A), HEADPHONE_BYPASS-1.1, MIC_BYPASS-1.1, Q1.3 (D), R15.1, R-BYP-SENSE-1.2
/LINE_IN_L: C33.2, U1.22 (LIN2)
/LINE_IN_R: C34.2, U1.21 (RIN2)
/LINE_OUT_L: C27.2, C50.2, U1.12 (LOUT1)
/LINE_OUT_R: C48.2, C49.2, U1.11 (ROUT1)
/MCLK: HDR-CP-L-1.1, U1.1 (MCLK)
/MIC_AMPLIFIED: C26.1, U1.24 (LIN1)
/MIC_BIAS_SRC: JP-MIC-BIAS-1.2, R-ELEC-1.1
/MIC_IN_P: C23.1, R-MICBIAS-1.1, U5.3 (+)
/MIC_PREAMP_OUT: C26.2, C-MIC-AIR-1.1, R10.1, U5.1
/MIC_RAW: C23.2, J-LEMO-1.4, J-MIC-IN-1.1, MIC_BYPASS-1.2, R-ELEC-1.2
/MIC_TO_PLANE: J-AIRCRAFT-1.4, MIC_BYPASS-1.3
/MIC_TO_RELAY: C-MIC-AIR-1.2, MIC_BYPASS-1.4
/PTT_PASS: J-AIRCRAFT-1.5, PTT_PASS/GND-1.1
/Q1_GATE: J-PANEL-1.3, Q1.1 (G), R-GATE-1.2, R-PULL-1.1
/TPA_IN_L: C1.1, R-TPA-IN-1.2
/TPA_IN_L_N: R-TPA-FB-1.1, R-TPA-IN-1.1, U8.2 (IN1-)
/TPA_IN_R: C2.1, R-TPA-IN-2.2
/TPA_IN_R_N: R-TPA-FB-2.1, R-TPA-IN-2.1, U8.6 (IN2-)
/USB_5V: J-USB5V-1.1, J-USB-1.A4 (VBUS), J-USB-1.A9 (VBUS), J-USB-1.B4 (VBUS), J-USB-1.B9 (VBUS)
/USB_CC1: J-USB-1.A5 (CC1), R-CC-1.2
/USB_CC2: J-USB-1.B5 (CC2), R-CC-2.2
/VMID: C41.2, U1.20 (VMID)
/VMID_BIAS: C25.1, R-BIAS1.1, R-BIAS2.2, R-MICBIAS-1.2, U5.5 (+)
/VREF: C39.2, U1.10 (VREF)
GND: C3.1, C6.2, C7.2, C8.2, C19.1, C20.2, C21.2, C22.1, C24.1, C25.2, C28.2, C29.2, C30.2, C31.1, C32.1, C35.2, C36.2, C37.2, C38.2, C42.1, C46.2, C47.2, C51.2, C-BULK-3V3.2, C-DRV-REG-1.2, C-DRV-VDD-1.2, C-DRV-VDD-2.2, C-ENC-IA.2, C-ENC-IB.2, C-ENC-OA.2, C-ENC-OB.2, C-ENC-PUSH.2, D4.1 (K), D5.1 (K), D6.1 (K), D7.1 (K), FB1.1, HDR-CP-R-1.6, J-BAT-1.2, J-BAT-2.2, J-BTN-1.2, J-BTN-IN-1.4, J-ENC-1.1, J-ENC-1.7, J-PANEL-1.2, J-PANEL-1.4, J-USB5V-1.2, J-USB-1.A1 (GND), J-USB-1.A12 (GND), J-USB-1.B1 (GND), J-USB-1.B12 (GND), J-USB-1.SH (SHIELD), PTT_PASS/GND-1.2, Q1.2 (S), R1.2, R8.1, R11.2, R-BIAS2.1, R-CC-1.1, R-CC-2.1, R-PULL-1.2, TP1.1, TP2.1, U1.4 (DGND), U1.26 (CE), U1.29 (EPAD), U2.4 (IN/TRIG), U2.8 (GND), U3.1 (A0), U3.2 (A1), U3.3 (A2), U3.8 (GND), U6.2 (GND), U8.4 (GND), U8.5 (SHUTDOWN); also elsewhere on the board
unnamed: C24.2, R9.1
unnamed: D3.2 (A), L2.2, U6.1 (SW)
unnamed: D4.2 (A), R12.2
unnamed: D5.2 (A), R13.2
unnamed: D6.2 (A), R14.2
unnamed: D7.2 (A), R15.2
unnamed: C33.1, J-35-1.1
unnamed: C34.1, J-35-1.2
unnamed: C27.1, J-35-2.1
unnamed: C48.1, J-35-2.2
unnamed: C50.1, J-35-3.1
unnamed: C49.1, J-35-3.2
unnamed: R9.2, R10.2, U5.2 (-)
unnamed: U5.6 (-), U5.7
unnamed: R11.1, R-FB-TOP-2.2, U6.3 (FB)
unnamed: C9.2, U8.3 (BYPASS)

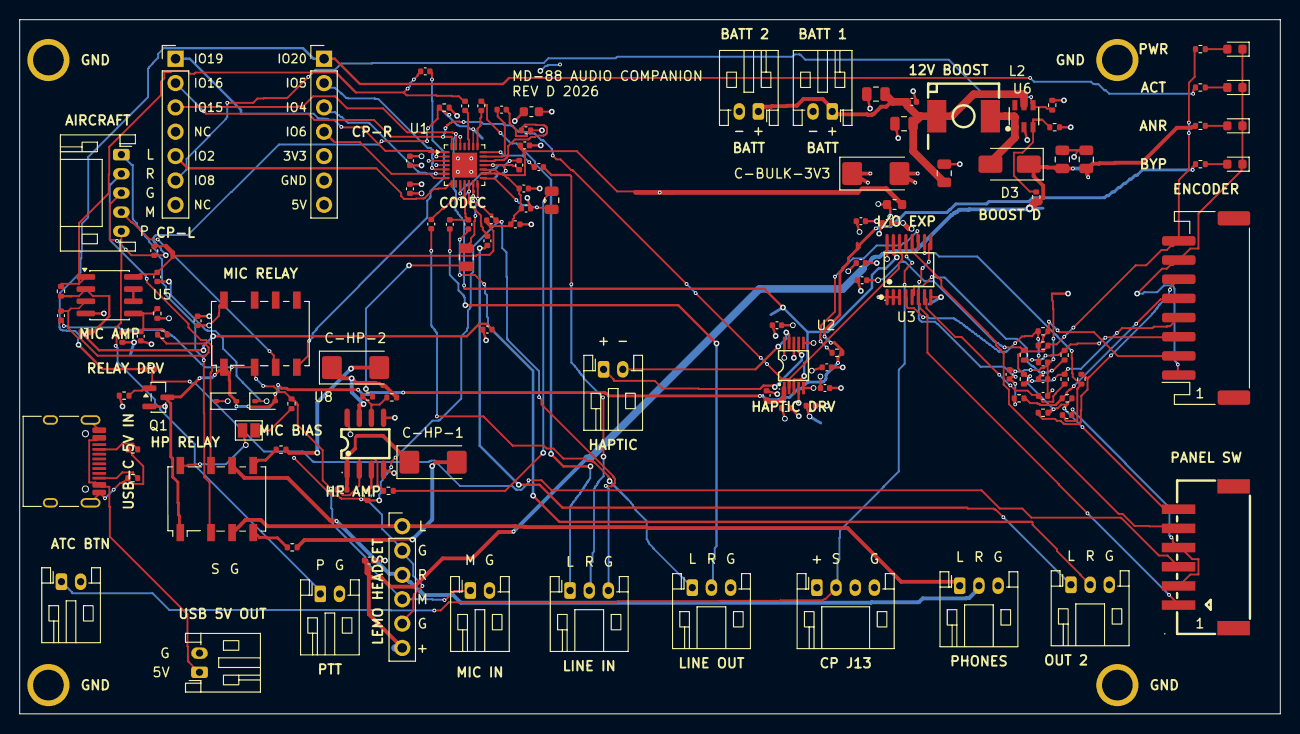
[picture p7: board audio_companion.kicad_pcb from above]

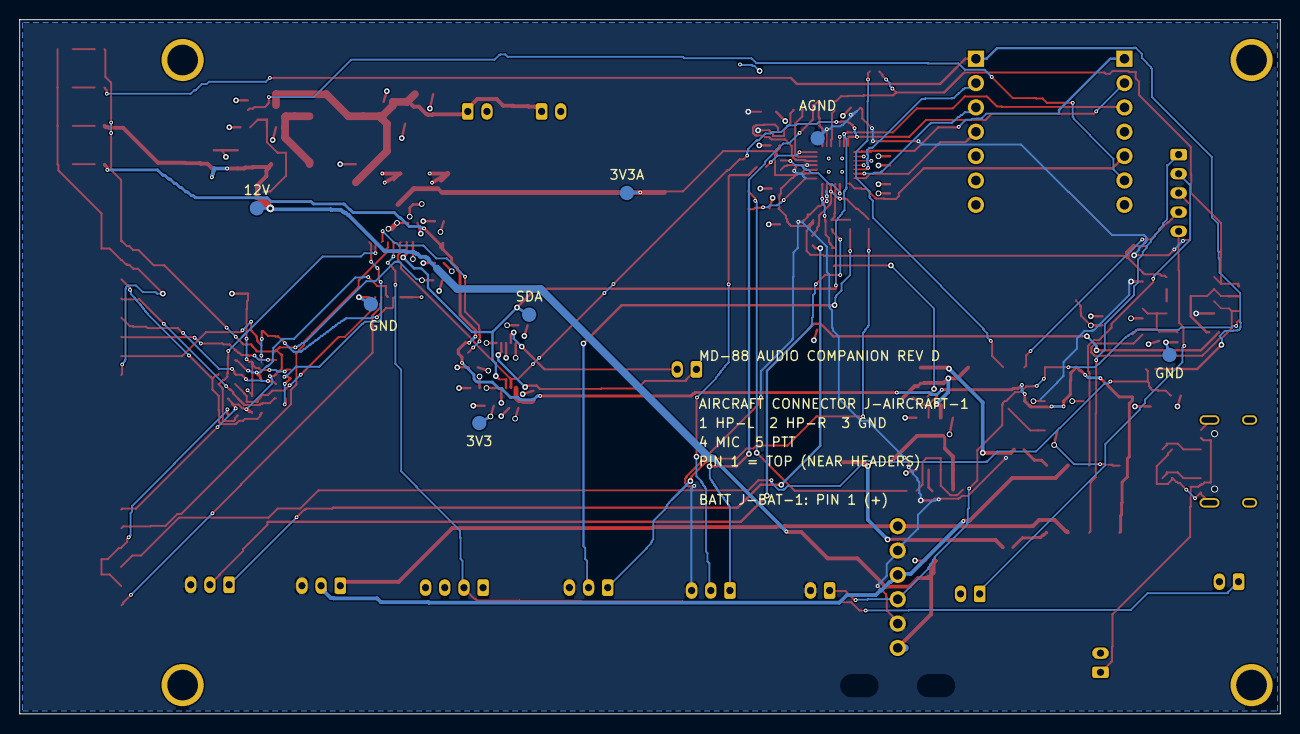
[picture p8: board audio_companion.kicad_pcb from below]

Board: 4 copper layers, 131.5 x 72.4 mm, 137 parts (7 on the bottom side), 85 nets.

Other parts of the board:
H1, H2, H3, H4: MountingHole_3.2mm_M3_NPTH; MountingHole_3.2mm_M3

Their connections:
GND: H1.1, H2.1, H3.1, H4.1; also elsewhere on the board
