md80av8r/AudioBox/md88_breakout/md88_breakout_main_revC.kicad_pcb

## KiCad design md88_breakout/md88_breakout_main_revC.kicad_pcb (2026-06-02)

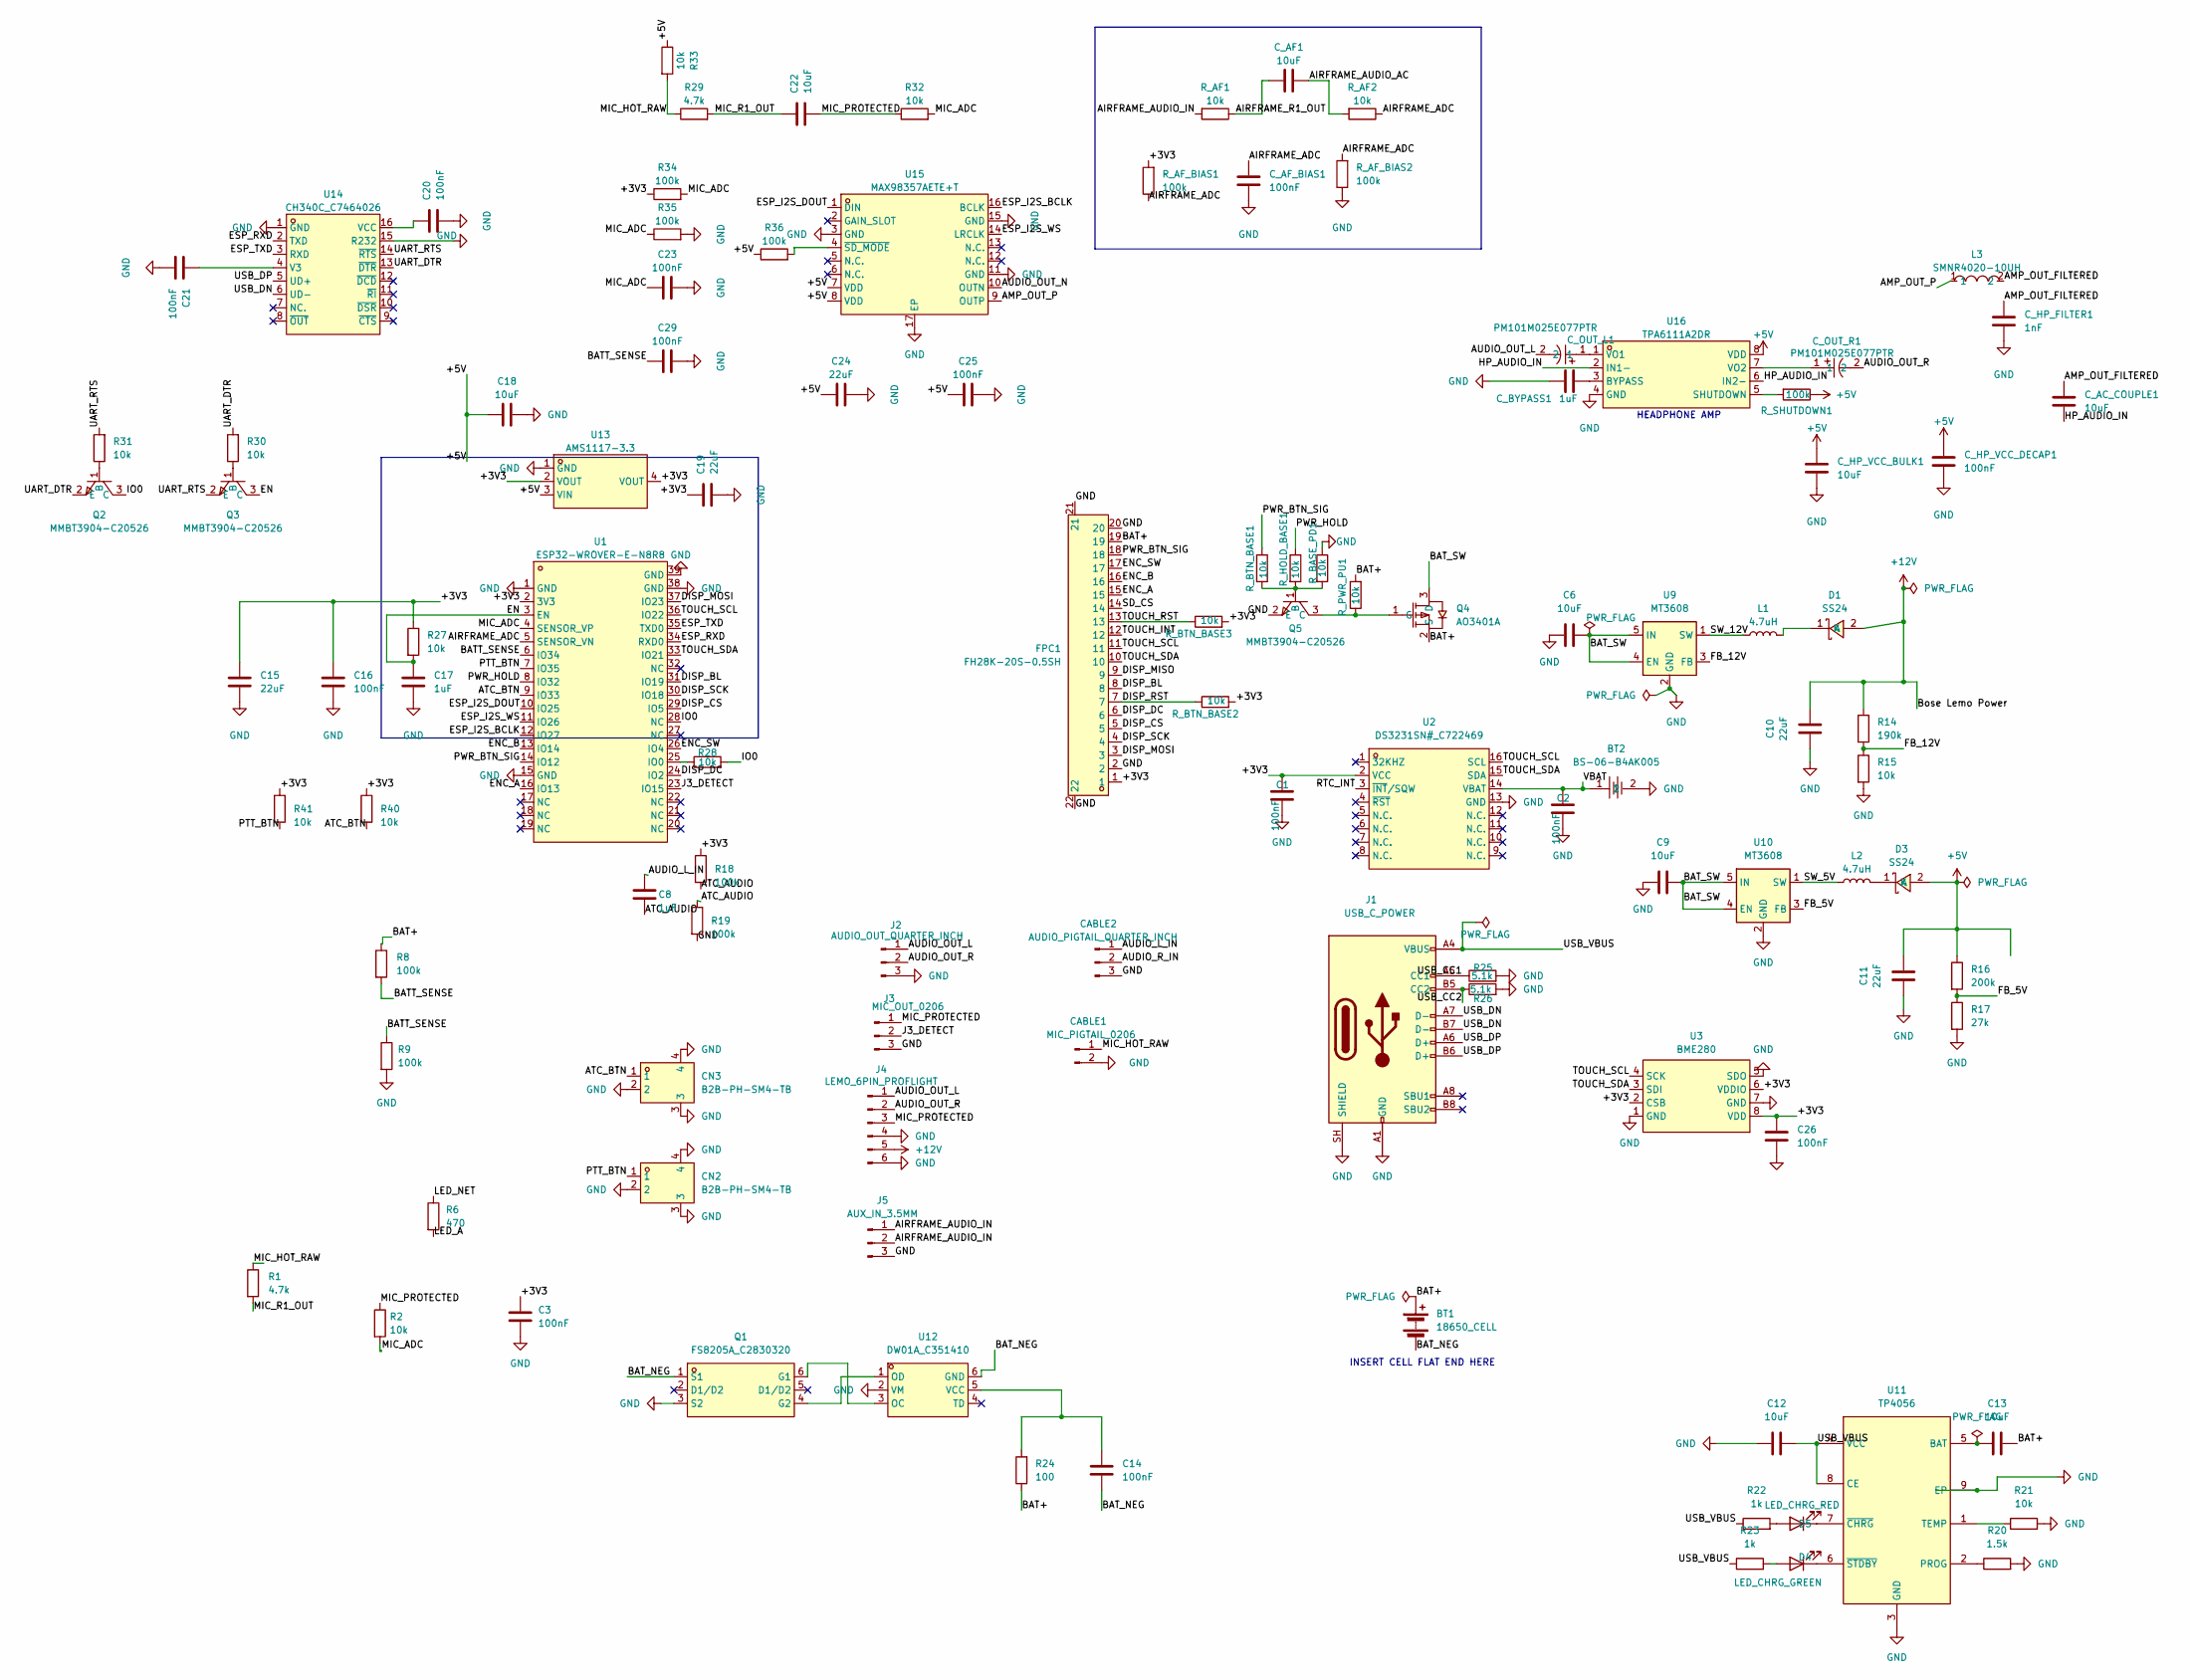
[picture p9: schematic md88_breakout_main_revC.kicad_sch]

Parts:
BT1: 18650_CELL; CONN-SMD_B2B-PH-SM4-TB-LF-SN
BT2: BS-06-B4AK005; BAT-SMD_BS-CR2032-8; MPN BS-06-B4AK005; LCSC Part C964766
C1, C2, C3, C14, C16, C20, C21, C23, C25, C26, C29: 100nF; C_0805_2012Metric
C6, C9, C12, C13, C18: 10uF; C_0805_2012Metric
C8, C17: 1uF; C_0805_2012Metric
C10, C11, C15, C19, C24: 22uF; C_0805_2012Metric
C22: 10uF; C_1210_3225Metric
CABLE1: MIC_PIGTAIL_0206; CONN-SMD_B2B-PH-SM4-TB-LF-SN
CABLE2: AUDIO_PIGTAIL_QUARTER_INCH; CONN-SMD_B3B-PH-SM4-TB-LF-SN
CN2, CN3: B2B-PH-SM4-TB; CONN-SMD_B2B-PH-SM4-TB-LF-SN; MPN B2B-PH-SM4-TB(LF)(SN); LCSC Part C160352
C_AC_COUPLE1: 10uF; C_1210_3225Metric
C_AF1: 10uF; C_1210_3225Metric
C_AF_BIAS1: 100nF; C_1210_3225Metric
C_BYPASS1: 1uF; C_0805_2012Metric
C_HP_FILTER1: 1nF; C_0805_2012Metric
C_HP_VCC_BULK1: 10uF; C_0805_2012Metric
C_HP_VCC_DECAP1: 100nF; C_0805_2012Metric
C_OUT_L1: PM101M025E077PTR; CAP-SMD_BD6.3-L6.6-W6.6-LS7.2-FD; MPN PM101M025E077PTR; LCSC Part C2858382
C_OUT_R1: PM101M025E077PTR; CAP-SMD_BD6.3-L6.6-W6.6-LS7.2-FD; MPN PM101M025E077PTR; LCSC Part C2858382
D1, D3: SS24; SMA_L4.3-W2.6-LS5.2-RD; MPN SS24; LCSC Part C50645
D4: LED_CHRG_RED; LED_0805_2012Metric
D5: LED_CHRG_GREEN; LED_0805_2012Metric
FPC1: FH28K-20S-0.5SH; CONN-SMD_FH28K-20S-0.5SH; MPN FH28K-20S-0.5SH; LCSC Part C3168665
J1: USB_C_POWER; USB_C_Receptacle_HRO_TYPE-C-31-M-12
J2: AUDIO_OUT_QUARTER_INCH; CONN-SMD_B3B-PH-SM4-TB-LF-SN
J3: MIC_OUT_0206; CONN-SMD_B3B-PH-SM4-TB-LF-SN
J4: LEMO_6PIN_PROFLIGHT; CONN-SMD_6P-P2.00_B6B-PH-SM4-TB-LF-SN
J5: AUX_IN_3.5MM; CONN-SMD_B3B-PH-SM4-TB-LF-SN
L1, L2: 4.7uH; IND-SMD_L4.0-W4.0_LQH44PN2R2MP0L
L3: SMNR4020-10UH; IND-SMD_L4.0-W4.0_LQH44PN2R2MP0L; MPN SMNR4020-10UH; LCSC Part C135263
Q1: FS8205A_C2830320; SOT-23-6_L2.9-W1.6-P0.95-LS2.8-BR; MPN FS8205A; LCSC Part C2830320
Q2, Q3, Q5: MMBT3904-C20526; SOT-23-3_L2.9-W1.3-P1.90-LS2.4-BR; MPN MMBT3904(RANGE:100-300); LCSC Part C20526
Q4: AO3401A; SOT-23_L2.9-W1.3-P1.90-LS2.4-BR; MPN AO3401A; LCSC Part C15127
R1, R29: 4.7k; R_0805_2012Metric
R2, R15, R21, R27, R28, R30, R31, R32, R33, R40, R41: 10k; R_0805_2012Metric
R6: 470; R_0805_2012Metric
R8, R9, R18, R19, R34, R35, R36: 100k; R_0805_2012Metric
R14: 190k; R_0805_2012Metric
R16: 200k; R_0805_2012Metric
R17: 27k; R_0805_2012Metric
R20: 1.5k
R22, R23: 1k; R_0805_2012Metric
R24: 100; R_0805_2012Metric
R25, R26: 5.1k; R_0805_2012Metric
R_AF1, R_AF2: 10k; R_0805_2012Metric
R_AF_BIAS1, R_AF_BIAS2: 100k; R_0805_2012Metric
R_BASE_PD1: 10k; R_0805_2012Metric
R_BTN_BASE1, R_BTN_BASE2, R_BTN_BASE3: 10k; R_0805_2012Metric
R_HOLD_BASE1: 10k; R_0805_2012Metric
R_PWR_PU1: 10k; R_0805_2012Metric
R_SHUTDOWN1: 100k; R_0805_2012Metric
U1: ESP32-WROVER-E-N8R8; WIFI-SMD_ESP32-WROVER-IE8MB; MPN ESP32-WROVER-E-N8R8; LCSC Part C2973667
U2: DS3231SN#_C722469; SOIC-16_L10.3-W7.5-P1.27-LS10.3-BL; MPN DS3231SN#; LCSC Part C722469
U3: BME280; LGA-8_BME280_BL; MPN BME280; LCSC Part C92489
U9, U10: MT3608; SOT-23-6
U11: TP4056; ESOP-8_L4.9-W3.9-P1.27-LS6.0-BL-EP; MPN TP4056-42-ESOP8; LCSC Part C16581
U12: DW01A_C351410; SOT-23-6_L2.9-W1.6-P0.95-LS2.8-BL; MPN DW01A; LCSC Part C351410
U13: AMS1117-3.3; SOT-223-3_L6.5-W3.4-P2.30-LS7.0-BR; MPN AMS1117-3.3; LCSC Part C6186
U14: CH340C_C7464026; SOP-16_L10.0-W3.9-P1.27-LS6.0-BL; MPN CH340C; LCSC Part C7464026
U15: MAX98357AETE+T; TQFN-16_L3.0-W3.0-P0.50-BL-EP1.5; MPN MAX98357AETE+T; LCSC Part C910544
U16: TPA6111A2DR; SOIC-8_L5.0-W4.0-P1.27-LS6.0-BL; MPN TPA6111A2DR; LCSC Part C497472

Connections:
+5V: C11.2, C18.2, C24.1, C25.1, C_HP_VCC_BULK1.1, C_HP_VCC_DECAP1.1, D3.2 (A), R16.1, R33.1, R36.1, R_SHUTDOWN1.1, U13.3 (VIN), U15.7 (VDD), U15.8 (VDD), U16.8 (VDD)
+12V: C10.2, D1.2 (A), J4.5, R14.1
/+3V3: C1.2, C3.1, C15.1, C16.1, C19.2, C26.1, FPC1.1, R18.1, R27.1, R34.1, R40.1, R41.1, R_AF_BIAS1.2, R_BTN_BASE2.2, R_BTN_BASE3.2, U1.2 (3V3), U2.2 (VCC), U3.2 (CSB), U3.6 (VDDIO), U3.8 (VDD), U13.2 (VOUT), U13.4 (VOUT)
/AIRFRAME_ADC: C_AF_BIAS1.1, R_AF2.1, R_AF_BIAS1.1, R_AF_BIAS2.2, U1.5 (SENSOR_VN)
/AIRFRAME_AUDIO_AC: C_AF1.2, R_AF2.2
/AIRFRAME_AUDIO_IN: J5.1, J5.2, R_AF1.2
/AIRFRAME_R1_OUT: C_AF1.1, R_AF1.1
/AMP_OUT_FILTERED: C_AC_COUPLE1.1, C_HP_FILTER1.1, L3.2
/AMP_OUT_P: L3.1, U15.9 (OUTP)
/ATC_AUDIO: C8.2, R18.2, R19.1
/ATC_BTN: CN3.1, R40.2, U1.9 (IO33)
/AUDIO_L_IN: C8.1, CABLE2.1
/AUDIO_OUT_L: C_OUT_L1.2, J2.1, J4.1
/AUDIO_OUT_N: U15.10 (OUTN)
/AUDIO_OUT_R: C_OUT_R1.2, J2.2, J4.2
/AUDIO_R_IN: CABLE2.2
/BATT_SENSE: C29.1, R8.2, R9.1, U1.6 (IO34)
/BAT_NEG: BT1.2 (-), C14.1, Q1.1 (S1), U12.6 (GND)
/BAT_SW: C6.2, C9.2, Q4.3 (D), U9.4 (EN), U9.5 (IN), U10.4 (EN), U10.5 (IN)
/DISP_BL: FPC1.8, U1.31 (IO19)
/DISP_CS: FPC1.5, U1.29 (IO5)
/DISP_DC: FPC1.6, U1.24 (IO2)
/DISP_MISO: FPC1.9
/DISP_MOSI: FPC1.3, U1.37 (IO23)
/DISP_RST: FPC1.7, R_BTN_BASE2.1
/DISP_SCK: FPC1.4, U1.30 (IO18)
/EN: C17.2, Q3.3 (C), R27.2, U1.3 (EN)
/ENC_A: FPC1.15, U1.16 (IO13)
/ENC_B: FPC1.16, U1.13 (IO14)
/ENC_SW: FPC1.17, U1.26 (IO4)
/ESP_I2S_BCLK: U1.12 (IO27), U15.16 (BCLK)
/ESP_I2S_DOUT: U1.10 (IO25), U15.1 (DIN)
/ESP_I2S_WS: U1.11 (IO26), U15.14 (LRCLK)
/ESP_RXD: U1.34 (RXD0), U14.2 (TXD)
/ESP_TXD: U1.35 (TXD0), U14.3 (RXD)
/FB_5V: R16.2, R17.1, U10.3 (FB)
/FB_12V: R14.2, R15.1, U9.3 (FB)
/HP_AUDIO_IN: C_AC_COUPLE1.2, U16.2 (IN1-), U16.6 (IN2-)
/IO0: Q2.3 (C), R28.2, U1.28 (NC)
/J3_DETECT: J3.2, U1.23 (IO15)
/LED_A: R6.2
/LED_NET: R6.1
/MIC_ADC: C23.1, R2.2, R32.2, R34.2, R35.1, U1.4 (SENSOR_VP)
/MIC_HOT_RAW: CABLE1.1, R1.1, R29.1, R33.2
/MIC_PROTECTED: C22.1, J3.1, J4.3, R2.1, R32.1
/MIC_R1_OUT: C22.2, R1.2, R29.2
/PTT_BTN: CN2.1, R41.2, U1.7 (IO35)
/PWR_BTN_SIG: FPC1.18, R_BTN_BASE1.1, U1.14 (IO12)
/PWR_HOLD: R_HOLD_BASE1.1, U1.8 (IO32)
/RTC_INT: U2.3 (~INT/SQW)
/SD_CS: FPC1.14
/SW_5V: L2.1, U10.1 (SW)
/SW_12V: L1.1, U9.1 (SW)
/TOUCH_INT: FPC1.12
/TOUCH_RST: FPC1.13, R_BTN_BASE3.1
/TOUCH_SCL: FPC1.11, U1.36 (IO22), U2.16 (SCL), U3.4 (SCK)
/TOUCH_SDA: FPC1.10, U1.33 (IO21), U2.15 (SDA), U3.3 (SDI)
/UART_DTR: Q2.2 (E), R30.2, U14.13 (~DTR)
/UART_RTS: Q3.2 (E), R31.2, U14.14 (~RTS)
/USB_CC1: J1.A5 (CC1), R25.1
/USB_CC2: J1.B5 (CC2), R26.1
/USB_DN: J1.A7 (D-), J1.B7 (D-), U14.6 (UD-)
/USB_DP: J1.A6 (D+), J1.B6 (D+), U14.5 (UD+)
/USB_VBUS: C12.2, J1.A4 (VBUS), J1.A9 (VBUS), J1.B4 (VBUS), J1.B9 (VBUS), R22.1, R23.1, U11.4 (VCC), U11.8 (CE)
/VBAT: BT2.1, C2.2, U2.14 (VBAT)
unnamed: D1.1 (K), L1.2
unnamed: D3.1 (K), L2.2
unnamed: D4.2 (A), R22.2
unnamed: D4.1 (K), U11.7 (~CHRG)
unnamed: D5.2 (A), R23.2
unnamed: D5.1 (K), U11.6 (~STDBY)
unnamed: Q1.6 (G1), U12.3 (OC)
unnamed: Q1.4 (G2), U12.1 (OD)
unnamed: Q2.1 (B), R31.1
unnamed: Q3.1 (B), R30.1
unnamed: Q4.1 (G), Q5.3 (C), R_PWR_PU1.1
unnamed: Q5.1 (B), R_BASE_PD1.2, R_BTN_BASE1.2, R_HOLD_BASE1.2
unnamed: R28.1, U1.25 (IO0)
unnamed: C13.1, U11.5 (BAT)
unnamed: R20.1, U11.2 (PROG)
unnamed: R21.1, U11.1 (TEMP)
unnamed: C14.2, R24.2, U12.5 (VCC)
unnamed: C21.2, U14.4 (V3)
unnamed: C20.2, U14.16 (VCC)
unnamed: R36.2, U15.4 (~SD_MODE)
unnamed: C_BYPASS1.2, U16.3 (BYPASS)
unnamed: R_SHUTDOWN1.2, U16.5 (SHUTDOWN)
unnamed: C_OUT_L1.1, U16.1 (VO1)
unnamed: C_OUT_R1.1, U16.7 (VO2)

Notes on the sheet:
INSERT CELL FLAT END HERE
HEADPHONE AMP

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
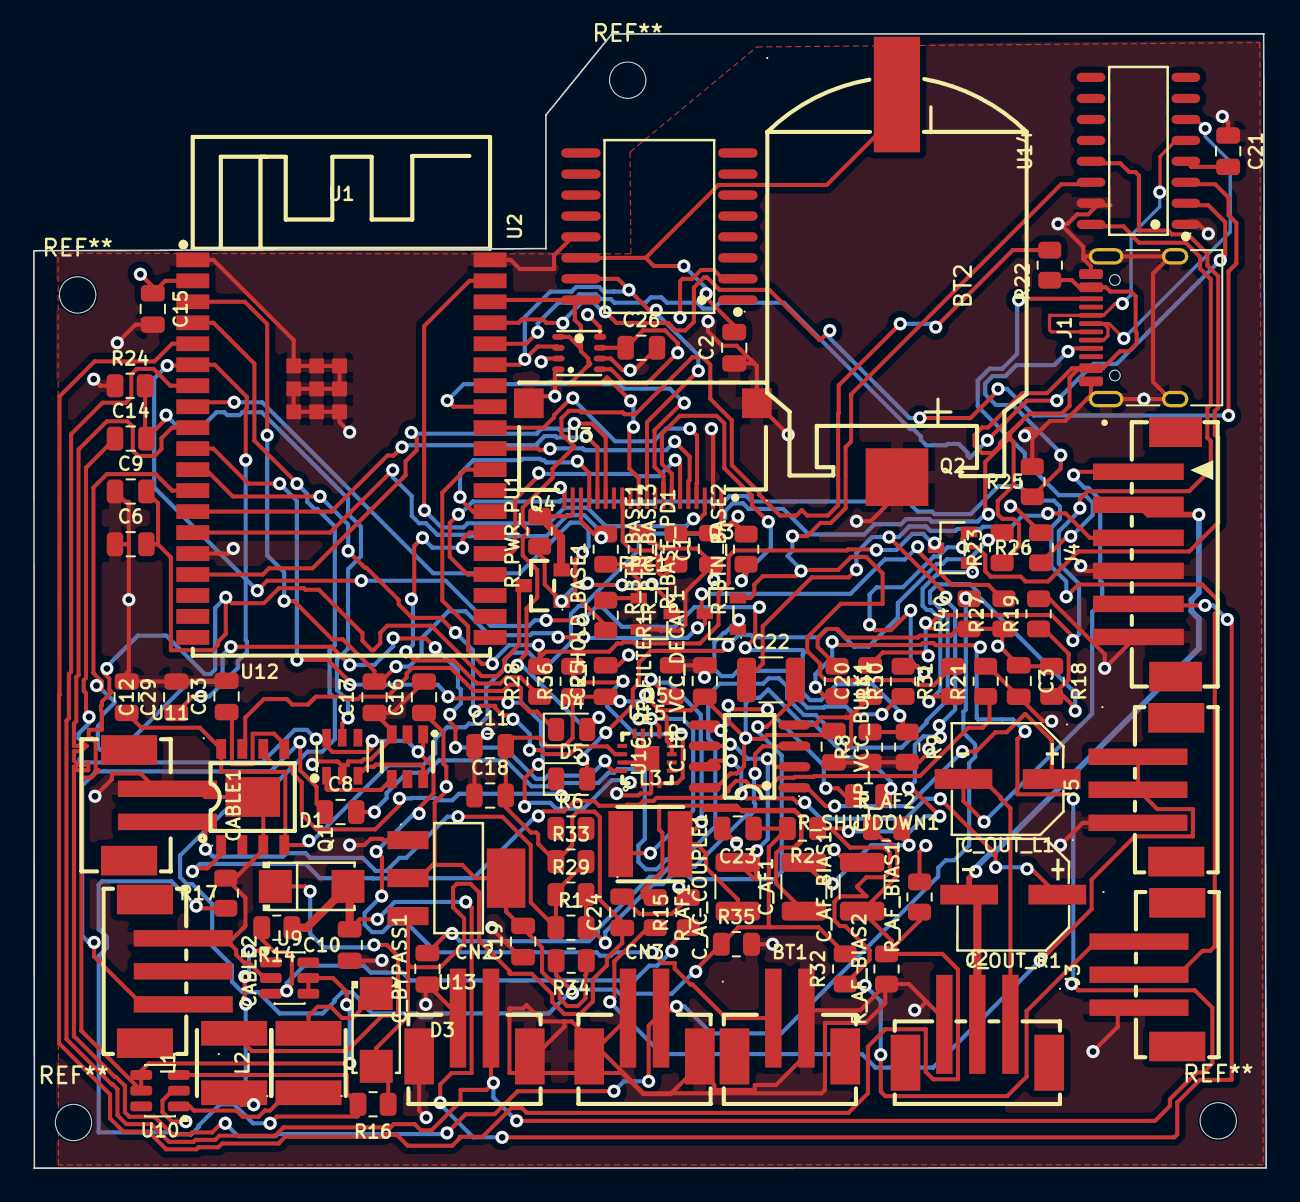
[picture p10: board md88_breakout_main_revC.kicad_pcb from above]

Board: 4 copper layers, 74.6 x 68.7 mm, 108 parts (0 on the bottom side), 82 nets.
