md80av8r/AudioBox/md88_panel/md88_panel_revC.kicad_pcb

## KiCad design md88_panel/md88_panel_revC.kicad_pcb (2026-06-02)

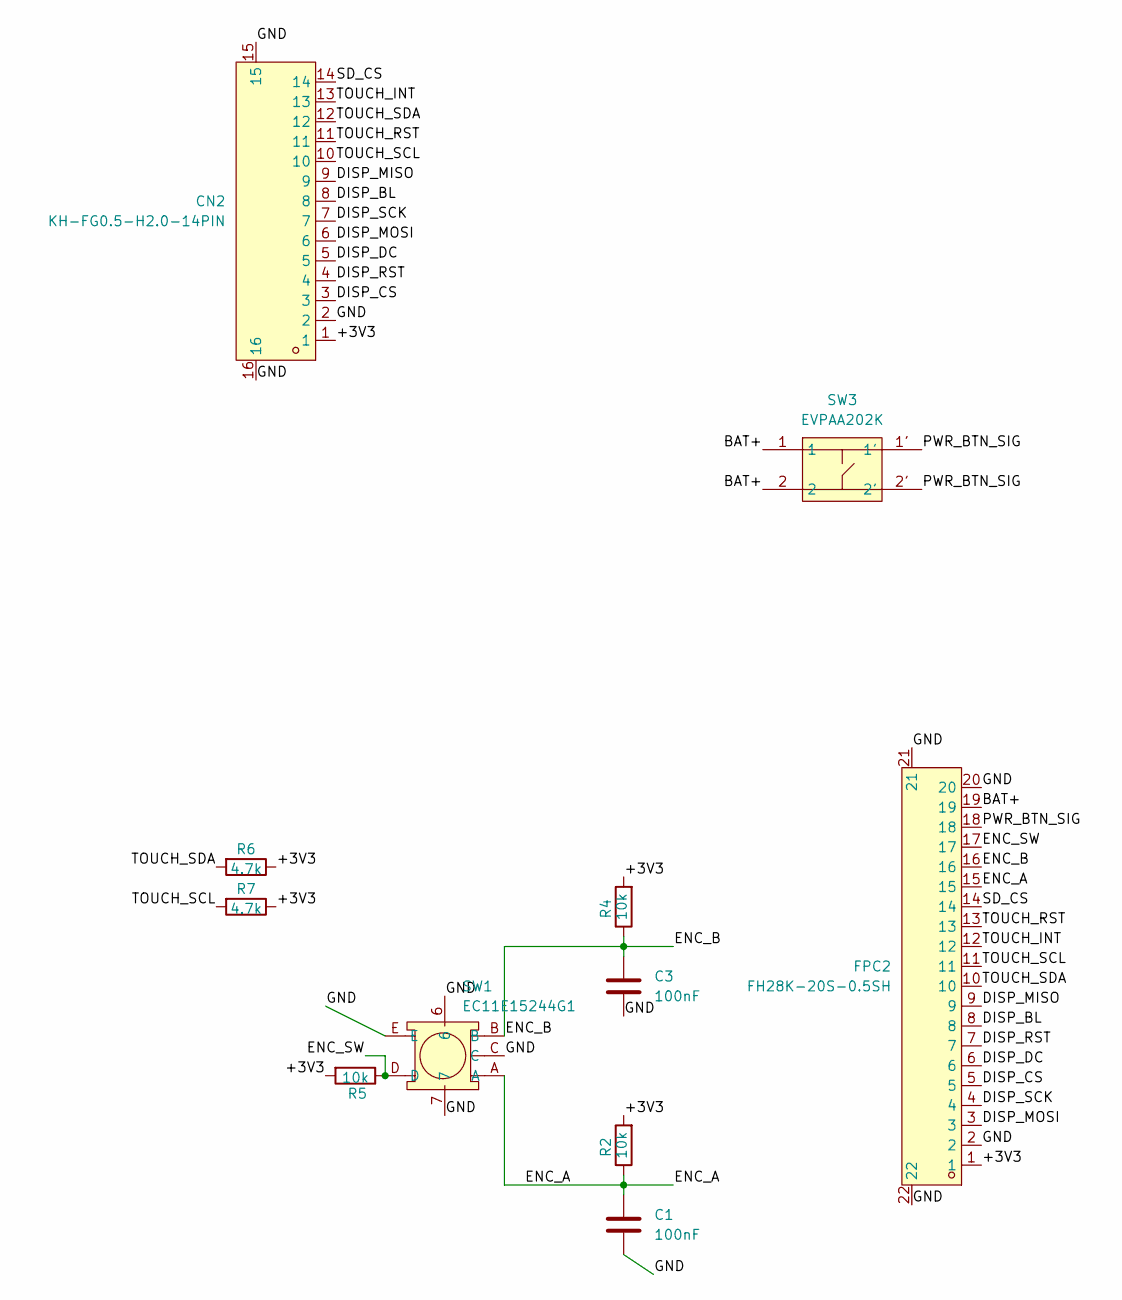
[picture p11: schematic md88_panel_revC.kicad_sch]

Parts:
C1, C3: 100nF; C_0805_2012Metric
CN2: KH-FG0.5-H2.0-14PIN; FPC-SMD_KH-FG0.5-H2.0-14PIN; MPN KH-FG0.5-H2.0-14PIN; LCSC Part C2797208
FPC2: FH28K-20S-0.5SH; CONN-SMD_FH28K-20S-0.5SH; MPN FH28K-20S-0.5SH; LCSC Part C3168665
R2, R4, R5: 10k; R_0805_2012Metric
R6, R7: 4.7k; R_0805_2012Metric
SW1: EC11E15244G1; SW-TH_EC11E15244G1; MPN EC11E15244G1; LCSC Part C370970
SW3: EVPAA202K; KEY-SMD_4P-L3.5-W2.9-P1.48-LS4.3-TL; MPN EVPAA202K; LCSC Part C79147

Connections:
/+3V3: CN2.1, FPC2.1, R2.2, R4.2, R5.2, R6.1, R7.1
/BAT+: FPC2.19, SW3.1, SW3.2
/DISP_BL: CN2.8, FPC2.8
/DISP_CS: CN2.3, FPC2.5
/DISP_DC: CN2.5, FPC2.6
/DISP_MISO: CN2.9, FPC2.9
/DISP_MOSI: CN2.6, FPC2.3
/DISP_RST: CN2.4, FPC2.7
/DISP_SCK: CN2.7, FPC2.4
/ENC_A: C1.1, FPC2.15, R2.1, SW1.A
/ENC_B: C3.1, FPC2.16, R4.1, SW1.B
/ENC_SW: FPC2.17, R5.1, SW1.D
/GND: C1.2, C3.2, CN2.2, CN2.15, CN2.16, FPC2.2, FPC2.20, FPC2.21, FPC2.22, SW1.6, SW1.7, SW1.C, SW1.E
/PWR_BTN_SIG: FPC2.18, SW3.1', SW3.2'
/SD_CS: CN2.14, FPC2.14
/TOUCH_INT: CN2.13, FPC2.12
/TOUCH_RST: CN2.11, FPC2.13
/TOUCH_SCL: CN2.10, FPC2.11, R7.2
/TOUCH_SDA: CN2.12, FPC2.10, R6.2

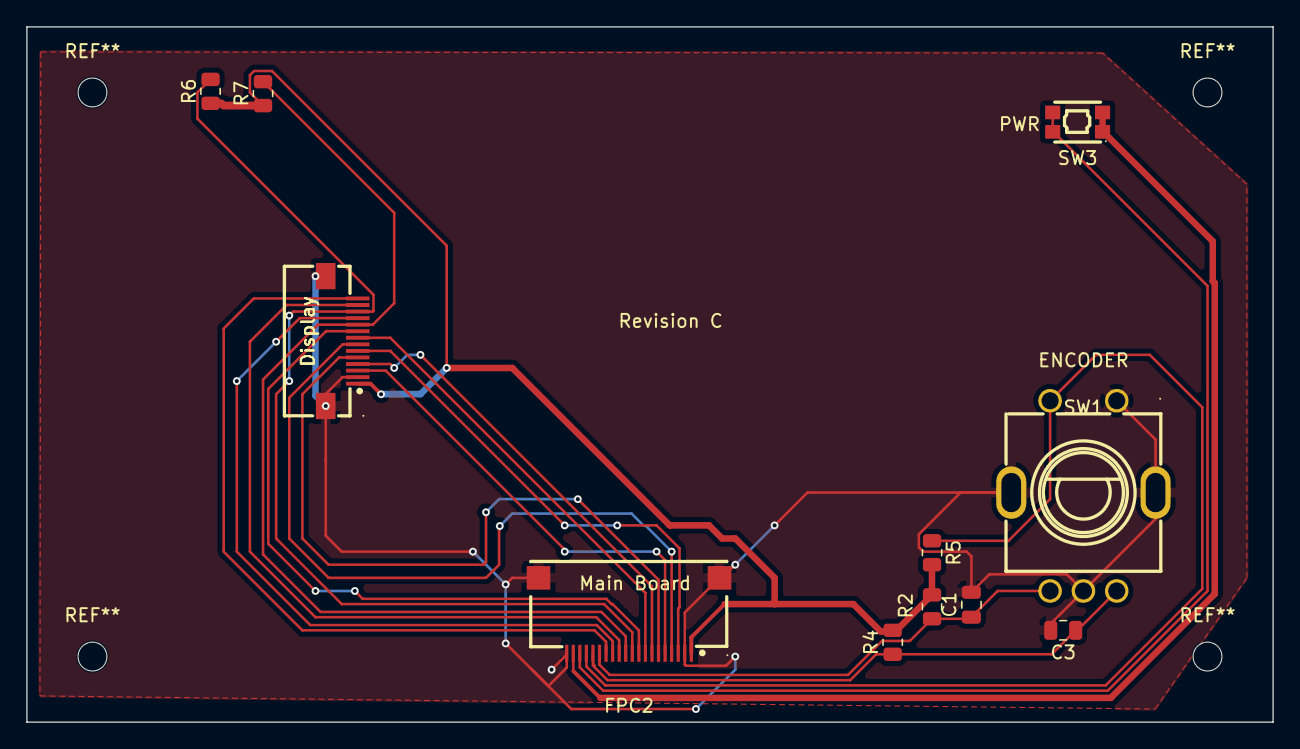
[picture p12: board md88_panel_revC.kicad_pcb from above]

Board: 2 copper layers, 95.0 x 53.0 mm, 11 parts (0 on the bottom side), 19 nets.
