md80av8r/AudioBox/md88_breakout/_archive_revB/md88_breakout.kicad_pcb

## KiCad design md88_breakout/_archive_revB/md88_breakout.kicad_pcb (2026-06-02, an earlier design)

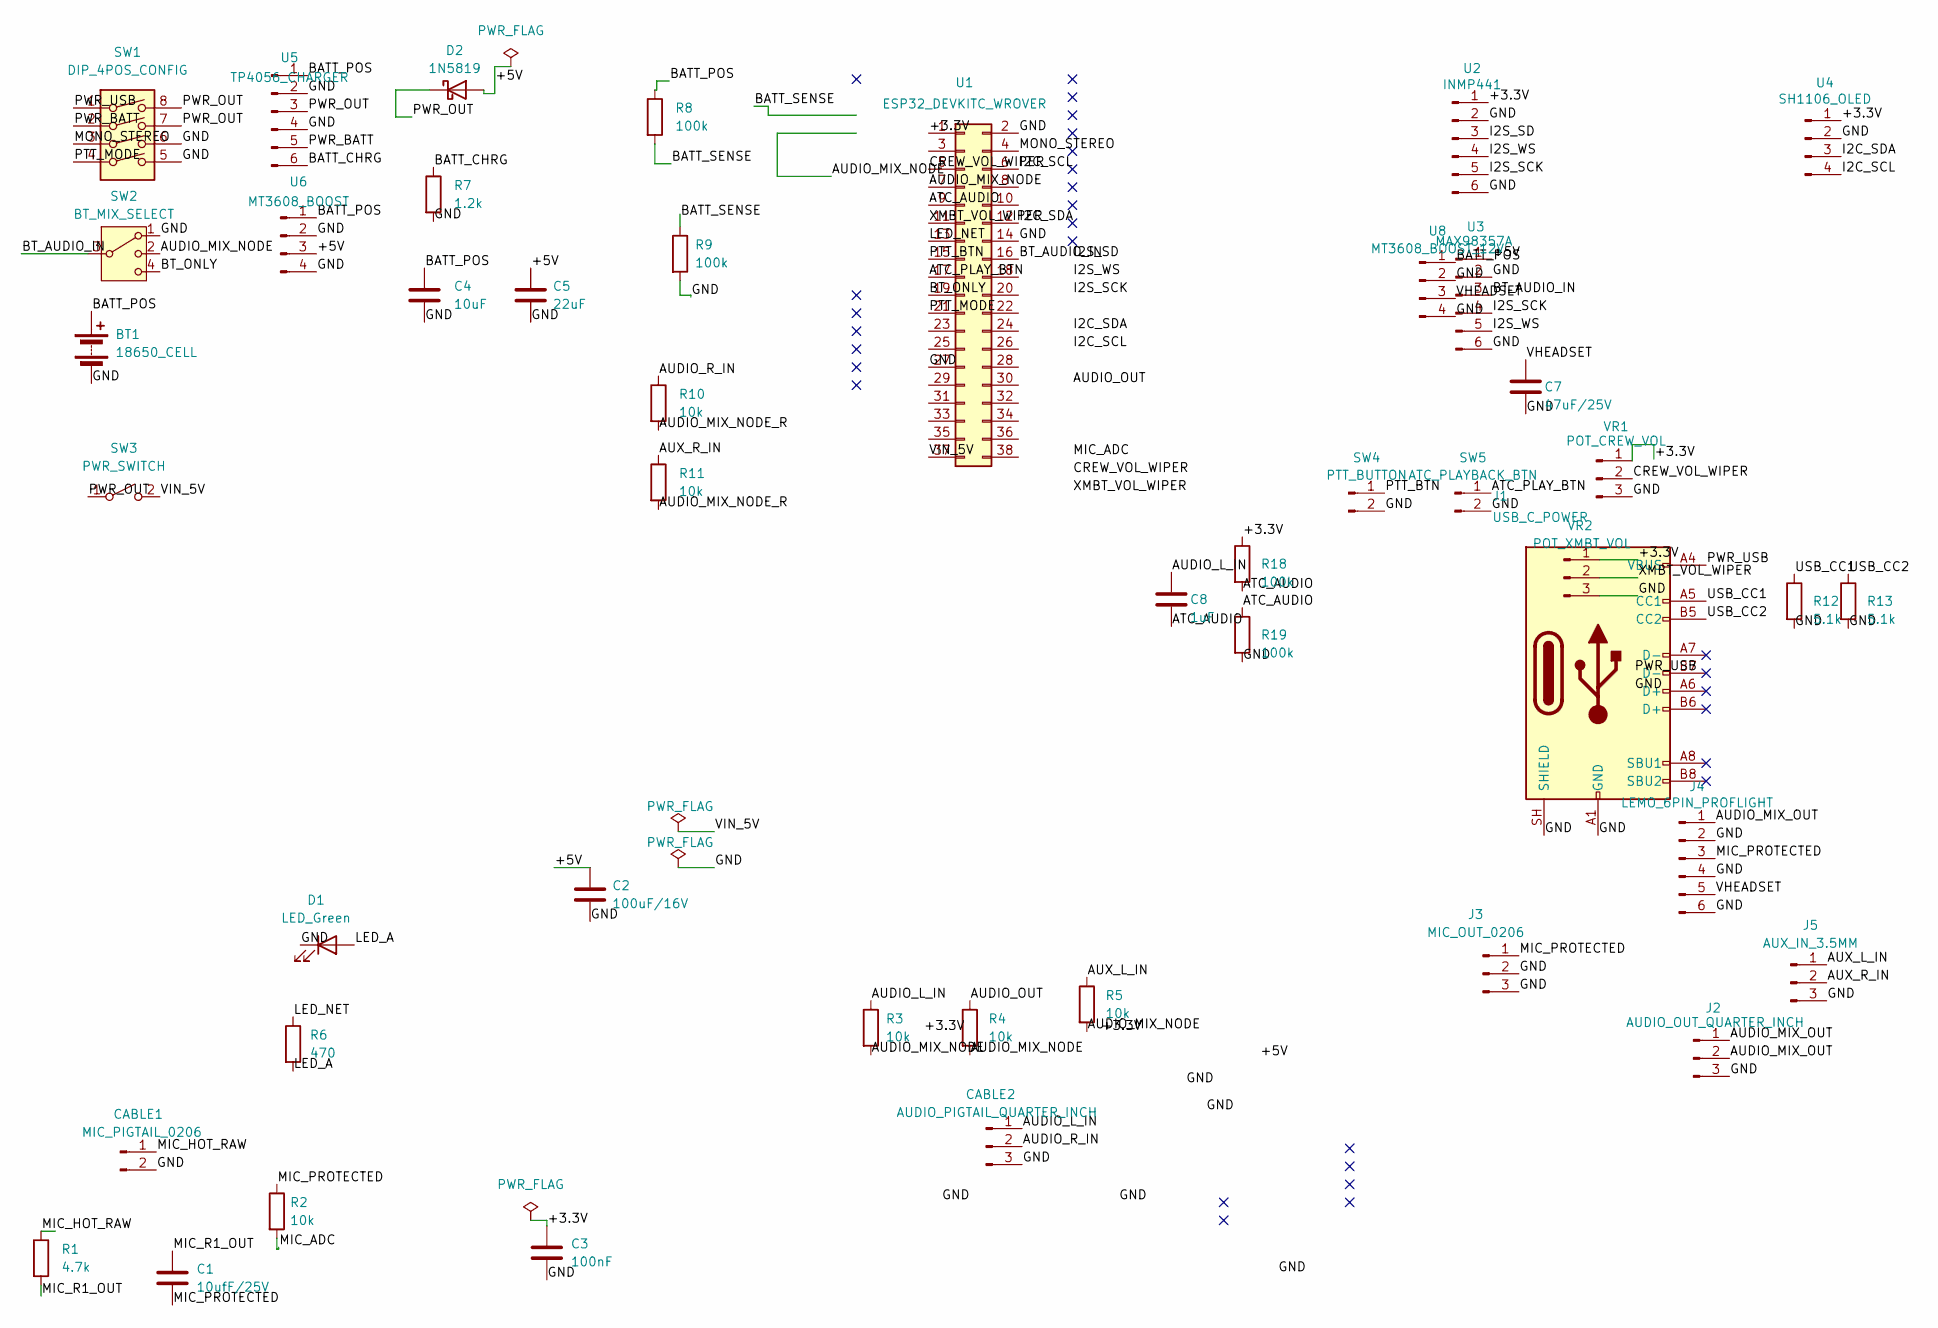
[picture p13: schematic md88_breakout.kicad_sch]

Parts:
BT1: 18650_CELL; BatteryHolder_Keystone_1042_1x18650
C1: 10ufF/25V; CP_Radial_D5.0mm_P2.00mm
C2: 100uF/16V; CP_Radial_D6.3mm_P2.50mm
C3: 100nF; C_0805_2012Metric
C4: 10uF; CP_Radial_D5.0mm_P2.00mm
C5: 22uF; CP_Radial_D6.3mm_P2.50mm
C7: 47uF/25V; CP_Radial_D6.3mm_P2.50mm
C8: 1uF; C_0805_2012Metric
CABLE1: MIC_PIGTAIL_0206; JST_PH_B2B-PH-K_1x02_P2.00mm_Vertical
CABLE2: AUDIO_PIGTAIL_QUARTER_INCH; JST_PH_B3B-PH-K_1x03_P2.00mm_Vertical
D1: LED_Green; LED_D3.0mm
D2: 1N5819; D_DO-41_SOD81_P10.16mm_Horizontal
J1: USB_C_POWER; USB_C_Receptacle_GCT_USB4105-xx-A_16P_TopMnt_Horizontal
J2: AUDIO_OUT_QUARTER_INCH; PinHeader_1x03_P2.54mm_Vertical
J3: MIC_OUT_0206; PinHeader_1x03_P2.54mm_Vertical
J4: LEMO_6PIN_PROFLIGHT; PinHeader_1x06_P2.54mm_Vertical
J5: AUX_IN_3.5MM; PinHeader_1x03_P2.54mm_Vertical
R1: 4.7k; R_0805_2012Metric
R2, R3, R4, R5, R10, R11: 10k; R_0805_2012Metric
R6: 470; R_0805_2012Metric
R7: 1.2k; R_Axial_DIN0207_L6.3mm_D2.5mm_P10.16mm_Horizontal
R8, R9, R18, R19: 100k; R_0805_2012Metric
R12, R13: 5.1k; R_0805_2012Metric
SW1: DIP_4POS_CONFIG; SW_DIP_SPSTx04_Slide_9.78x12.34mm_W7.62mm_P2.54mm
SW2: BT_MIX_SELECT; SW_SP3T_PCM13
SW3: PWR_SWITCH; SW_DIP_SPSTx01_Slide_6.7x4.1mm_W7.62mm_P2.54mm_LowProfile
SW4: PTT_BUTTON; PinHeader_1x02_P2.54mm_Vertical
SW5: ATC_PLAYBACK_BTN; PinHeader_1x02_P2.54mm_Vertical
U1: ESP32_DEVKITC_WROVER; ESP32_DevKitC_V4
U2: INMP441; PinHeader_1x06_P2.54mm_Vertical
U3: MAX98357A; PinHeader_1x06_P2.54mm_Vertical
U4: SH1106_OLED; PinHeader_1x04_P2.54mm_Vertical
U5: TP4056_CHARGER; PinHeader_1x06_P2.54mm_Vertical
U6: MT3608_BOOST; PinHeader_1x04_P2.54mm_Vertical
U8: MT3608_BOOST_12V; PinHeader_1x04_P2.54mm_Vertical
VR1: POT_CREW_VOL; Potentiometer_Alps_RK09K_Single_Vertical
VR2: POT_XMBT_VOL; Potentiometer_Alps_RK09K_Single_Vertical

Connections:
/+3.3V: C3.1, R18.1, U1.1, U2.1, U4.1, VR1.1, VR2.1
/+5V: C2.1, C5.1, D2.2 (A), U3.1, U6.3
/ATC_AUDIO: C8.2, R18.2, R19.1, U1.9
/ATC_PLAY_BTN: SW5.1, U1.17
/AUDIO_L_IN: C8.1, CABLE2.1, R3.1
/AUDIO_MIX_NODE: R3.2, R4.2, R5.2, SW2.2, U1.7
/AUDIO_MIX_NODE_R: R10.2, R11.2
/AUDIO_MIX_OUT: J2.1, J2.2, J4.1
/AUDIO_OUT: R4.1
/AUDIO_R_IN: CABLE2.2, R10.1
/AUX_L_IN: J5.1, R5.1
/AUX_R_IN: J5.2, R11.1
/BATT_CHRG: R7.1, U5.6
/BATT_POS: BT1.1 (+), C4.1, R8.1, U5.1, U6.1, U8.1
/BATT_SENSE: R8.2, R9.1
/BT_AUDIO_IN: SW2.3, U1.16, U3.3
/BT_ONLY: SW2.4, U1.19
/CREW_VOL_WIPER: U1.5, VR1.2
/GND: BT1.2 (-), C2.2, C3.2, C4.2, C5.2, C7.2, CABLE1.2, CABLE2.3, D1.1 (K), J1.A1 (GND), J1.A12 (GND), J1.B1 (GND), J1.B12 (GND), J1.SH (SHIELD), J2.3, J3.2, J3.3, J4.2, J4.4, J4.6, J5.3, R7.2, R9.2, R12.2, R13.2, R19.2, SW1.5, SW1.6, SW2.1, SW4.2, SW5.2, U1.2, U1.14, U1.27, U2.2, U2.6, U3.2, U3.6, U4.2, U5.2, U5.4, U6.2, U6.4, U8.2, U8.4, VR1.3, VR2.3
/I2C_SCL: U1.6, U4.4
/I2C_SDA: U1.12, U4.3
/I2S_SCK: U2.5, U3.4
/I2S_SD: U2.3
/I2S_WS: U2.4, U3.5
/LED_A: D1.2 (A), R6.2
/LED_NET: R6.1, U1.13
/MIC_ADC: R2.2
/MIC_HOT_RAW: CABLE1.1, R1.1
/MIC_PROTECTED: C1.2, J3.1, J4.3, R2.1
/MIC_R1_OUT: C1.1, R1.2
/MONO_STEREO: SW1.3, U1.4
/PTT_BTN: SW4.1, U1.15
/PTT_MODE: SW1.4, U1.21
/PWR_BATT: SW1.2, U5.5
/PWR_OUT: D2.1 (K), SW1.7, SW1.8, SW3.1 (A), U5.3
/PWR_USB: J1.A4 (VBUS), J1.A9 (VBUS), J1.B4 (VBUS), J1.B9 (VBUS), SW1.1
/USB_CC1: J1.A5 (CC1), R12.1
/USB_CC2: J1.B5 (CC2), R13.1
/VHEADSET: C7.1, J4.5, U8.3
/VIN_5V: SW3.2 (B), U1.37
/XMBT_VOL_WIPER: U1.11, VR2.2

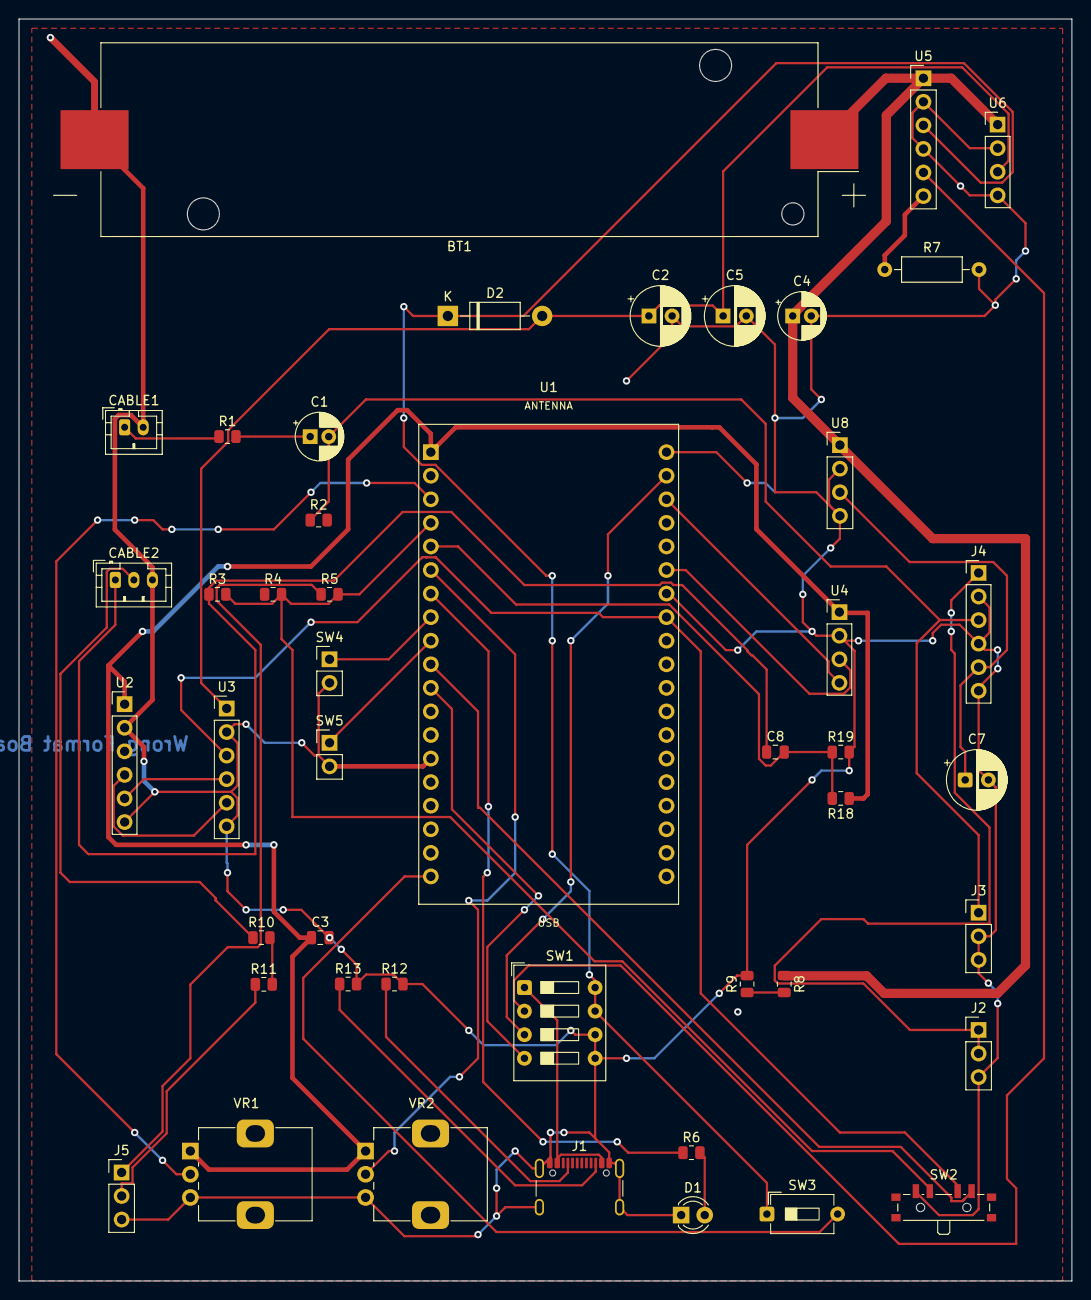
[picture p14: board md88_breakout.kicad_pcb from above]

Board: 2 copper layers, 113.5 x 136.0 mm, 46 parts (0 on the bottom side), 38 nets.
