md80av8r/AudioBox/(commit log)

2026-06-02 Initial commit — Rev C complete, Rev D architecture captured
    Rev C status:
    - Main board (4-layer) and panel board (2-layer) in production at JLC
    - Schematic bug fixes captured: BT1 power path, J4 Bose pinout, value typos
    - BT2 (CR2032) marked DNP — handled by hand-solder after delivery
    Rev D planning complete:
    - ESP32-S3-WROOM-1-N16R8 with native USB
    - Dual USB-C with FUSB302 smart power management
    - microSD slot for audio storage
    - BLE-only (drops A2DP, uses USB Audio Class)
    - Pin map drafted in REV_D_PINMAP.md + firmware/src/pins_revD.h
    Firmware:
    - PlatformIO + Wokwi scaffold for rev C target
    - LVGL UI: home + menu + audio screens (Pro-Pilot color scheme)
    - FreeRTOS task layout (ui,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
2026-10-28 Add audio companion GPIO pin header for Elecrow ESP32-S3
    Claude-Session: https://claude.ai/code/session_01B2aiSiD6Cx9nzsDdpqVGvD
2026-10-28 Add ESP-IDF I2C scan project for companion board bring-up
    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
2026-10-31 Add diagnostics screen (LVGL) for the audio companion board
    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
2026-10-31 Add bring-up to-do list (purchases, tests, board bug)
    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
2026-10-31 Add encoder firmware: polled quadrature decode via the expander, shown on diagnostics screen
    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
2026-11-01 Tone test: report which stage failed and wait for previous run to finish
    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
2026-11-04 Add I2S pin test button to the diagnostics screen
    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
2026-11-05 Pin test also shows codec registers 0x00, 0x02 and 0x08
    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
2026-11-05 Add self-test, report page and I2C/GPIO/tone web bench tools
    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
2026-11-05 Add mic level bar and mic gain slider; read the ADC while the mic monitor runs
    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
2026-11-05 Add LINE OUT to LINE IN loopback test (replaces the Haptic button for now)
    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
2026-11-12 Record confirmed relay coil polarity bug and workaround
    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
2026-11-12 Record first working audio on board A
    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
2026-11-12 Add mic input scan page; level meter covers both ADC channels
    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
2026-11-12 Mic: set ADC volume to 0 dB, digital sidetone, steadier input scan
    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
2026-11-12 BRINGUP_TODO: zip-tie slot note
    Claude-Session: https://claude.ai/code/session_01B2aiSjWcgyeZHaVFSsmSyp
2026-11-12 Audio companion: consolidate project, bring-up findings, Revision_20 start
    - Add audio_companion/ (as-ordered Y15 board, v19_r3 respin board, schematic,
    libs, fab_v7, scripts, 3D viewer) with master RESPIN_CHECKLIST.md
    - Merge bring-up findings into one v20 must-fix list; BRINGUP_TODO points to it
    - Record mic bias rework (0.98 kohm, Lemo pins 6-4), battery hookup, relay bridge
    - Add Audio_Companion_Lessons_Learned PDF + HTML source
    - Add Revision_20/ and the JLCPCB Y15 production package (order JSON kept local)
2026-11-12 Add JLCPCB Y15 BOM (CSV) confirming as-ordered part references
2026-11-12 Add original JLCPCB Y15 BOM (xls)
